esech19/tvc-and-test-rig/README.md

# tvc-and-testing
tvc rocket project and test setup
