esech19/tvc-and-test-rig/Misc/Final Project Timeline.docx

Plan for Final TVC Rocket

Tuesday 4/18

- Discuss testing and make a plan/schedule to work around capstone

Wednesday 4/19

- Could meet with mark at 1pm?
- Work on code - Ian and Jah
  - Either AM or PM, we might be more awake in PM

Thursday 4/20

- Elijah to get transfer functions output from testing after time align
- Ian to get parachute code done and functional by Mark meeting
- Mark meeting @3 PM
- Generate PID values from transfer functions from real dynamics and upload PID values to rocket

Friday 4/21

- Elijah leaves AM

Saturday 4/22

- Elijah gone
- Ian could test the rocket?

Sunday 4/23

- Elijah back PM

Monday 4/24

- New sweep test day, any additional data necessary

Tuesday 4/25

- Get rocket ready for launch
  - Launch lugs
  - Shock cord
  - Deploy final TVC code

Wednesday 4/26

- TVC Test Day 1

Thursday 4/27

- Mark meeting @3 PM

Friday 4/28

Saturday 4/29

- TVC Test Day 2
- Ian needs to work on HRI project some

Sunday 4/30

- Generate any graphs/tables/pictures/videos
- Ian needs to work on HRI project some

Monday 3/1

- Finish poster day

Tuesday 3/2

- Poster complete by noon

Wednesday 3/3

- Poster presentation day
