esech19/tvc-and-test-rig/Misc/Component Weights.xlsx

Rocket | Part | Weight (g) | Total v1 (g) | Total v2
v1 | cardboard | 206 | 738 | 257
v1 | nosecone 3D print | 86
v1 | electrinics bay w/ electronics | 248
v1 | gimbal | 110
v1 | e 12-4 engine | 61
v1 | parachute | 27
v2 | parachute launcher | 257
