esech19/tvc-and-test-rig/Misc/Parts List_.xlsx

Sheet: Testing Rig Parts
Name | Type | Part No. | Price | Quantity | Total | Link | Note
Load Cell - 50kg, Disc (TAS606) | Load cell | SEN-13331 ROHS | 64.5 | 3 | 193.5 | https://www.sparkfun.com/products/13331 | Not sure how to mount this one
Load Sensor - 50kg (Generic) | Load cell | SEN-10245 | 4.50 | 3 | 13.5 | https://www.sparkfun.com/products/10245
Load Cell - 200kg, S-Type (TAS501) | Load cell | SEN-14282 ROHS | 64.5 | 3 | 193.5 | https://www.sparkfun.com/products/14282
NP32HS Series | Encoder | NP32HS R5K L2% (243121) | 15 | 2 | 30
AMT102-0512-I5000-S | Encoder | 490-AMT1020512I5000S | 22.95 | 2 | 45.9 | https://p3america.com/np32hs-series/ | https://www.mouser.com/c/sensors/encoders/?resolution=2048%20PPR&technology=Rotary
Alloy Steel Shoulder Screw,1/4" Shoulder Diameter, 3" Shoulder Length, 10-24 Thread | Shaft | 91259A106 | 2.72 | 4 | 10.88 | https://www.mcmaster.com/91259A106/
Fire Retardant Spray | Fireproofing | B07JBLHGQ8 | 34.95 | 1 | 34.95 | https://www.amazon.com/Retardant-Curtains-Eco-Safe-DRI-ONE-Institute/dp/B07JBLHGQ8
 |  |  | 37.4 | 2 | 74.8 | https://www.digikey.com/en/products/detail/cui-devices/AMT112Q-V-4096/5034549
13 x 46 Feet Anti Bird Netting, Green Garden Netting Protect Fruit and Vegetables from Birds and Animals, Bonus 20 PCS Cable Ties - 0.56 in Mesh | netting for test rig | B08PDGWNPN | 8.99 | 1 | 8.99 | https://www.amazon.com/Netting-Garden-Protect-Vegetables-Animals/dp/B08PDGWNPN
TRUE | SparkFun Load Sensor Combinator | Spark Fun | Combinator board | BOB-13878 ROHS (https://www.sparkfun.com/static/rohs/) | 2.1 | 1 | 2.1 | https://www.sparkfun.com/products/13878
 |  |  |  |  | 0
 |  |  |  |  | 0
 |  |  |  |  | 0
 |  |  |  |  | 0

Sheet: Testing Rig Parts Final
Purchased? | Name | Manufacturer | Type | Part No. | Price | Quantity | Total | Link | Note
TRUE | Load Cell - 200kg, S-Type (TAS501) | Spark Fun | Load cell | SEN-14282 ROHS | 64.5 | 2 | 129 | https://www.sparkfun.com/products/14282 | Not sure how to mount this one
TRUE | SparkFun Load Cell Amplifier - HX711 | Spark Fun | Amplifier Board for Load cells | SEN-13879 ROHS (https://www.sparkfun.com/static/rohs/) | 10.95 | 2 | 21.9 | https://www.sparkfun.com/products/13879
FALSE | AMT112Q-V-4096-ND | Digi Key | Encoder | AMT112Q-V-4096 | 37.4 | 2 | 74.8 | https://www.digikey.com/en/products/detail/cui-devices/AMT112Q-V-4096/5034549
TRUE | AMT103-2048-N4000-S | Digi Key | Encoder | AMT103-2048-N4000-S | 23.18 | 2 | 46.36 | https://www.digikey.com/en/products/detail/cui-devices/AMT103-2048-N4000-S/10468125
TRUE | CUI-435-1FT | Digi Key | encoder cable | CUI-435-1FT | 6.06 | 2 | 12.12 | https://www.digikey.com/en/products/detail/cui-devices/CUI-435-1FT/968159
FALSE | AMT ENCODER CABLE 17CONDUCTOR | Digi Key | cable | AMT-17C-1-036 | 43.54 | 2 | 87.08 | https://www.digikey.com/en/products/detail/cui-devices/AMT-17C-1-036/4864253
FALSE | sd card shield to save data
FALSE | Arduino microcontroller
 | power supply
FALSE | switch
TRUE | Zinc Alloy Tapping Inserts for Softwood, Flanged, 10-24 Thread Size, 25/64" Installed Length | McMaster Carr | inserts | 92105A006 (https://www.mcmaster.com/92105A006) | 8.08 | 1 | 8.08
TRUE | Worm-Drive Clamps for Firm Hose and Tube, Steel Screw, 9/16" Wide Band, 3-5/8" to 6-1/2" Clamp ID | MacMaster Carr | Hose clamp | 5415K87 (https://www.mcmaster.com/5415K87) | 14.6 | 1 | 14.6
TRUE | Alloy Steel Shoulder Screw, 1/4" Shoulder Diameter, 2-1/4" Shoulder Length, 10-24 Thread | McMaster Carr | Shoulder bolt | 91259A104 (https://www.mcmaster.com/91259A104) | 2.52 | 2 | 5.04 | https://www.mcmaster.com/catalog-128%2f3394/
TRUE | Alloy Steel Shoulder Screw 1/4" Shoulder Diameter, 1-3/8" Shoulder Length, 10-24 Thread | McMaster Carr | Shoulder bolt | 91259A471 (https://www.mcmaster.com/91259A471/) | 4.76 | 1 | 4.76
TRUE | 1/4" Shoulder Diameter, 1.75" Shoulder Length, 10-24 Thread | McMaster Carr | Shoulder bolt | 91259A102 (https://www.mcmaster.com/91259A102/) | 2.18 | 1 | 2.18
TRUE | Alloy Steel Socket Head Screw Black-Oxide, M12 x 1.75 mm Thread, 95 mm Long | McMaster Carr | Load cell bolt | 91290A367 (https://www.mcmaster.com/91290A367/) | 14.41 | 1 | 14.41 | https://www.mcmaster.com/91290A367/
TRUE | Aluminum Unthreaded Inserts for Plastic for 1/4" Screw Size, 1/4" Long | McMaster Carr | Gimbal hardware | 93729A108 (https://www.mcmaster.com/93729A108/) | 9.34 | 2 | 18.68
TRUE | Lubricant-Filled Nylon Plastic Washer for Number 12 Screw Size, 0.25" ID, 0.562" OD | McMaster Carr | Gimbal hardware | 91545A330 (https://www.mcmaster.com/91545A330/) | 4.14 | 2 | 8.28
FALSE | Fire Retardant Spray | amazon | Fireproofing | B07JBLHGQ8 | 34.95 | 1 | 34.95 | https://www.amazon.com/Retardant-Curtains-Eco-Safe-DRI-ONE-Institute/dp/B07JBLHGQ8 | https://www.mouser.com/c/sensors/encoders/?resolution=2048%20PPR&technology=Rotary
FALSE | Amazon Basics ABS 3D Printer Filament, 1.75mm, Red, 1 kg Spool |  | 3d Printing Spool |  | 20 | 5 | 100 | https://www.amazon.com/HATCHBOX-3D-Filament-Dimensional-Accuracy/dp/B00J0H8EWA?s=industrial |  | amazon
FALSE | 2x4 |  | Wood | N/A | 5 | 10 | 50 | none
FALSE | Zinc-Plated Steel Corner Bracket, 3" x 3" x 3/4" |  | angle brackets | 1556A36 (https://www.mcmaster.com/1556A36) | 1.43 | 4 | 5.72 | https://www.mcmaster.com/1556a35-zinc-plated-steel-corner-brackets/finish~zinc-plated/corner-brackets-5/
FALSE
FALSE
FALSE
FALSE
FALSE
FALSE
FALSE
FALSE
FALSE
FALSE
FALSE
FALSE
FALSE
FALSE
FALSE
FALSE
FALSE
FALSE
FALSE
FALSE
FALSE
FALSE
FALSE
FALSE
FALSE
FALSE
FALSE
FALSE
FALSE
FALSE
FALSE
FALSE
FALSE
FALSE
FALSE
FALSE
FALSE
FALSE
FALSE
FALSE
FALSE
FALSE
FALSE
FALSE
FALSE
FALSE
FALSE
FALSE
FALSE
FALSE
FALSE
FALSE
FALSE
FALSE
FALSE
FALSE
FALSE
FALSE
FALSE
FALSE
FALSE
FALSE
FALSE
FALSE
FALSE
FALSE
FALSE
FALSE
FALSE
FALSE
FALSE
FALSE
FALSE
FALSE
FALSE
FALSE
FALSE
FALSE
FALSE
FALSE
FALSE
FALSE
FALSE
FALSE
FALSE
FALSE
FALSE
FALSE
FALSE
FALSE
FALSE
FALSE
FALSE
FALSE
FALSE
FALSE
FALSE
FALSE
FALSE
FALSE
FALSE
FALSE
FALSE
FALSE
FALSE
FALSE
FALSE
FALSE
FALSE
FALSE
FALSE
FALSE
FALSE
FALSE
FALSE
FALSE
FALSE
FALSE
FALSE
FALSE
FALSE
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
FALSE
FALSE
FALSE
FALSE
FALSE
FALSE
FALSE
FALSE
FALSE
FALSE
FALSE
FALSE
FALSE
FALSE
FALSE
FALSE
FALSE
FALSE
FALSE
FALSE
FALSE
FALSE
FALSE
FALSE
FALSE
FALSE
FALSE
FALSE
FALSE
FALSE
FALSE
FALSE
FALSE
FALSE
FALSE
FALSE
FALSE
FALSE
FALSE
FALSE
FALSE
FALSE
FALSE
FALSE
FALSE
FALSE
FALSE
FALSE
FALSE
FALSE
FALSE
FALSE
FALSE
FALSE
FALSE
FALSE
FALSE
FALSE
FALSE
FALSE
FALSE
FALSE
FALSE
FALSE
FALSE
FALSE
FALSE
FALSE
FALSE
FALSE
FALSE
FALSE
FALSE
FALSE
FALSE
FALSE
FALSE
FALSE
FALSE
FALSE
FALSE
FALSE
FALSE
FALSE
FALSE
FALSE
FALSE
FALSE
FALSE
FALSE
FALSE
FALSE
FALSE
FALSE
FALSE
FALSE
FALSE
FALSE
FALSE
FALSE
FALSE
FALSE
FALSE
FALSE
FALSE
FALSE
FALSE
FALSE
FALSE
FALSE
FALSE
FALSE
FALSE
FALSE
FALSE
FALSE
FALSE
FALSE
FALSE
FALSE
FALSE
FALSE
FALSE
FALSE
FALSE
FALSE
FALSE
FALSE
FALSE
FALSE
FALSE
FALSE
FALSE
FALSE
FALSE
FALSE
FALSE
FALSE
FALSE
FALSE
FALSE
FALSE
FALSE
FALSE
FALSE
FALSE
FALSE
FALSE
FALSE
FALSE
FALSE
FALSE
FALSE
FALSE
FALSE
FALSE
FALSE
FALSE
FALSE
FALSE
FALSE

Sheet: Electronics
Name | Part No. | Price | Quantity | Total | Link | Note
Arduino Nano 33 BLE with headers | ABX00034 | 29.3 | 1 | 29.3 | https://store-usa.arduino.cc/collections/boards/products/arduino-nano-33-ble-with-headers
 |  |  |  | 0
 |  |  |  | 0
 |  |  |  | 0
 |  |  |  | 0
 |  |  |  | 0
 |  |  |  | 0
 |  |  |  | 0
 |  |  |  | 0
 |  |  |  | 0
 |  |  |  | 0
 |  |  |  | 0
 |  |  |  | 0
 |  |  |  | 0

Sheet: SURG Parts
 |  |  |  |  |  | 1005.75
Name | Vendor | Type | Part No. | Price | Quantity | Total | Link | Note
Load Cell - 50kg, Disc (TAS606) | Sparkfun | Load cell | SEN-13331 ROHS | 64.5 | 2 | 129 | here (https://www.sparkfun.com/products/13331)
Alloy Steel Shoulder Screw,1/4" Shoulder Diameter, 3" Shoulder Length, 10-24 Thread | Mcmaster Carr | Shaft | 91259A106 | 2.72 | 4 | 10.88 | here (https://www.mcmaster.com/91259A106/) | mcmaster carr
Fire Retardant Spray | Amazon | Fireproofing | B07JBLHGQ8 | 34.95 | 1 | 34.95 | here (https://www.amazon.com/Retardant-Curtains-Eco-Safe-DRI-ONE-Institute/dp/B07JBLHGQ8)
AMT112Q-V-4096 | Digi Key | Encoder | AMT112Q-V-4096 | 37.4 | 2 | 74.8 | here (https://www.digikey.com/en/products/detail/cui-devices/AMT112Q-V-4096/5034549)
2x4 | Home Depot | lumber |  | 5 | 10 | 50
Amazon Basics ABS 3D Printer Filament, 1.75mm, Red, 1 kg Spool | Amazon | 3d printing material |  | 20 | 5 | 100 | here (https://www.amazon.com/AmazonBasics-Printer-Filament-1-75mm-Spool/dp/B07Y3PHD2C) | amazon
AEROTECH 29MM HP SU DMS MOTOR - G12ST-P | Apogee Rockets | Rocket Motor | 81275 | 41.72 | 14 | 584.08 | here (https://www.apogeerockets.com/Rocket-Motors/AeroTech-Motors/29mm-Motors-Single-Use/Aerotech-29mm-HP-SU-DMS-Motor-G12ST-P)
13 x 46 Feet Anti Bird Netting, Green Garden Netting Protect Fruit and Vegetables from Birds and Animals, Bonus 20 PCS Cable Ties - 0.56 in Mesh | netting for test rig | B08PDGWNPN | 8.99 | 8.99 | 1 | 8.99 | here (https://www.amazon.com/Netting-Garden-Protect-Vegetables-Animals/dp/B08PDGWNPN)
SparkFun Load Cell Amplifier - HX711 | Amplifier Board for Load cells | SEN-13879 ROHS | 10.95 | 10.95 | 1 | 10.95 | here (https://www.sparkfun.com/products/13879)
SparkFun Load Sensor Combinator | Combinator board | BOB-13878 ROHS | 2.1 | 2.1 | 1 | 2.1 | here (https://www.sparkfun.com/products/13878)
 |  |  |  |  |  | 0

Sheet: Rocket 1 parts
Purchased? | Name | Manufacturer | Type | Part No. | Price | Quantity | Total | Link
FALSE | KST X06 Micro Digital Metal Gear Thin Servo |  | servo |  |  |  | 0 | https://www.amainhobbies.com/kst-x06-micro-digital-metal-gear-thin-servo-kst-x06/p1310013
FALSE | theta servo brushless |  |  |  |  |  | 0 | https://www.amainhobbies.com/theta-servos-thm988-brushless-mini-high-voltage-servo-ts-thm988/p1414874
TRUE | Arduino Nano 33 BLE [ABX00030] - | Arduino |  | B07WV59YTZ | 25 | 1 | 25 | https://www.amazon.com/Arduino-Nano-33-BLE/dp/B07WV59YTZ
TRUE | BMP390 Precision Barometric Pressure and Altimeter Sensor for Arduino | Adafruit | sensor | 4816 | 21 | 1 | 21 | https://www.adafruit.com/product/4816
TRUE | MG90S 9g Servo Motor Micro Metal Gear for Robot Car Plane RC Helicopter Arduino | ? |  | B07L6FZVT1 |  |  | 0 | https://www.amazon.com/MG90S-Servo-Motor-Helicopter-Arduino/dp/B07L6FZVT1/ref=sr_1_
TRUE | RC Plane battery 7.4V | Bloomisky |  | 0936T9B22 |  |  | 0 | https://www.amazon.com/Blomiky-500mAh-Rechargeable-Battery-Blaster/dp/B0936T9B22 7.4V 500mAh Li-ion Rechargeable Battery fit for WPL D12 RC Truck Anstoy 1085 1086 Gel Ball Blaster D12 Battery 2 -
TRUE | LM1085IT-5.0/NOPB | texas instruments | power converter | LM1085IT-5.0/NOPB-ND | 2.46 | 1 | 2.46 | https://www.digikey.com/en/products/detail/texas-instruments/LM1085IT-5-0-NOPB/363564
TRUE | TAP106K020SRW |  | capacitor | 478-8956-1-ND - Cut Tape (CT) | 0.25728 | 2 | 0.51456 | https://www.digikey.com/en/products/detail/kyocera-avx/TAP106K020SRW/1471143
TRUE | CAB-14574 | sparkfun, from digikey | battery connector |  | 1.06 | 1 | 1.06 | https://www.digikey.com/en/products/detail/sparkfun-electronics/CAB-14574/8543394
TRUE | PPTC151LFBN-RC |  |  | S7013-ND | 0.98 | 2 | 1.96 | https://www.digikey.com/en/products/detail/sullins-connector-solutions/PPTC151LFBN-RC/810153
TRUE | PPTC081LFBN-RC |  |  | S7006-ND | 0.65 | 1 | 0.65 | https://www.digikey.com/en/products/detail/sullins-connector-solutions/PPTC081LFBN-RC/810147
TRUE | PPTC061LFBN-RC |  |  | S7004-ND | 0.52 | 1 | 0.52 | https://www.digikey.com/en/products/detail/sullins-connector-solutions/PPTC061LFBN-RC/810145
TRUE | 10129378-936003BLF |  |  | 10129378-936003BLF-ND | 0.58 | 10 | 5.8 | https://www.digikey.com/en/products/detail/amphenol-cs-fci/10129378-936003BLF/7915975
FALSE |  |  |  |  |  |  | 0
FALSE |  |  |  |  |  |  | 0
FALSE |  |  |  |  |  |  | 0
FALSE |  |  |  |  |  |  | 0
FALSE |  |  |  |  |  |  | 0
FALSE |  |  |  |  |  |  | 0
FALSE |  |  |  |  |  |  | 0
FALSE |  |  |  |  |  |  | 0
FALSE |  |  |  |  |  |  | 0
FALSE |  |  |  |  |  |  | 0
FALSE |  |  |  |  |  |  | 0
FALSE |  |  |  |  |  |  | 0
FALSE |  |  |  |  |  |  | 0
FALSE |  |  |  |  |  |  | 0
FALSE |  |  |  |  |  |  | 0
FALSE |  |  |  |  |  |  | 0
FALSE |  |  |  |  |  |  | 0
FALSE |  |  |  |  |  |  | 0
FALSE |  |  |  |  |  |  | 0
FALSE |  |  |  |  |  |  | 0
FALSE |  |  |  |  |  |  | 0
FALSE |  |  |  |  |  |  | 0
FALSE |  |  |  |  |  |  | 0
FALSE |  |  |  |  |  |  | 0
FALSE |  |  |  |  |  |  | 0
FALSE |  |  |  |  |  |  | 0
FALSE |  |  |  |  |  |  | 0
FALSE |  |  |  |  |  |  | 0
FALSE |  |  |  |  |  |  | 0
FALSE |  |  |  |  |  |  | 0
FALSE |  |  |  |  |  |  | 0
FALSE |  |  |  |  |  |  | 0
FALSE |  |  |  |  |  |  | 0
FALSE |  |  |  |  |  |  | 0
FALSE |  |  |  |  |  |  | 0
FALSE |  |  |  |  |  |  | 0
FALSE |  |  |  |  |  |  | 0
FALSE |  |  |  |  |  |  | 0
FALSE |  |  |  |  |  |  | 0
FALSE |  |  |  |  |  |  | 0
FALSE |  |  |  |  |  |  | 0
FALSE |  |  |  |  |  |  | 0
FALSE |  |  |  |  |  |  | 0
FALSE |  |  |  |  |  |  | 0
FALSE
FALSE
FALSE
FALSE
FALSE
FALSE
FALSE
FALSE
FALSE
FALSE
FALSE
FALSE
FALSE
FALSE
FALSE
FALSE
FALSE
FALSE
FALSE
FALSE
FALSE
FALSE
FALSE
FALSE
FALSE
FALSE
FALSE
FALSE
FALSE
FALSE
FALSE
FALSE
FALSE
FALSE
FALSE
FALSE
FALSE
FALSE
FALSE
FALSE
FALSE
FALSE
FALSE
FALSE
FALSE
FALSE
FALSE
FALSE
FALSE
FALSE
FALSE
FALSE
FALSE
FALSE
FALSE
FALSE
FALSE
FALSE
FALSE
FALSE
FALSE
FALSE
FALSE
FALSE
FALSE
FALSE
FALSE
FALSE
FALSE
FALSE
FALSE
FALSE
FALSE
FALSE
FALSE
FALSE
FALSE
FALSE
FALSE
FALSE
FALSE
FALSE
FALSE
FALSE
FALSE
FALSE
FALSE
FALSE
FALSE
FALSE
FALSE
FALSE
FALSE
FALSE
FALSE
FALSE
FALSE
FALSE
FALSE
FALSE
FALSE
FALSE
FALSE
FALSE
FALSE
FALSE
FALSE
FALSE
FALSE
FALSE
FALSE
FALSE
FALSE
FALSE
FALSE
FALSE
FALSE
FALSE
FALSE
FALSE
FALSE
FALSE
FALSE
FALSE
FALSE
FALSE
FALSE
FALSE
FALSE
FALSE
FALSE
FALSE
FALSE
FALSE
FALSE
FALSE
FALSE
FALSE
FALSE
FALSE
FALSE
FALSE
FALSE
FALSE
FALSE
FALSE
FALSE
FALSE
FALSE
FALSE
FALSE
FALSE
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
FALSE
FALSE
FALSE
FALSE
FALSE
FALSE
FALSE
FALSE
FALSE
FALSE
FALSE
FALSE
FALSE
FALSE
FALSE
FALSE
FALSE
FALSE
FALSE
FALSE
FALSE
FALSE
FALSE
FALSE
FALSE
FALSE
FALSE
FALSE
FALSE
FALSE
FALSE
FALSE
FALSE
FALSE
FALSE
FALSE
FALSE
FALSE
FALSE
FALSE
FALSE
FALSE
FALSE
FALSE
FALSE
FALSE
FALSE
FALSE
FALSE
FALSE
FALSE
FALSE
FALSE
FALSE
FALSE
FALSE
FALSE
FALSE
FALSE
FALSE
FALSE
FALSE
FALSE
FALSE
FALSE
FALSE
FALSE
FALSE
FALSE
FALSE
FALSE
FALSE
FALSE
FALSE
FALSE
FALSE
FALSE
FALSE
FALSE
FALSE
FALSE
FALSE
FALSE
FALSE
FALSE
FALSE
FALSE
FALSE
FALSE

Sheet: Funding
Grant | Value | Total Grant $ | 500 | Purchase | Date | Value | Total
Holleran Feedback | 500 | Remaining $ | 206.3 | Rig Parts - McMaster Carr, Digi Key, Spark Fun | 2002-10-27 | 293.7 | 293.7

Sheet: Rocket 2 (rebuild)
Purchased? | Name | Manufacturer | Type | Part No. | Price | Quantity | Total | Link
FALSE | 36" PRINTED NYLON PARACHUTE | Apogee Compenents | Parachute | 29095 | 18.69 | 1 | 18.69 | https://www.apogeerockets.com/Building-Supplies/Parachutes/Larger-than-24in/36in-Printed-Nylon-Parachute
FALSE | Estes Motors - F15-8 | Apogee Compenents | Rocket Engines | 5797 | 33.69 | 2 | 67.38 | https://www.apogeerockets.com/Rocket_Motors/Estes_Motors/29mm_Motors/Estes_Motors_F15-8
