esech19/tvc-and-test-rig/Misc/SURG.xlsx

Item | Cost
36" PRINTED NYLON PARACHUTE | 18.69
1/8" DIAMETER HEAVY-DUTY ELASTIC SHOCK CORD | 5.3
APOGEE 12IN PARACHUTE PROTECTOR | 9.66
560PCS Heat Shrink Tubing 2:1,Electrical Wire Cable Wrap Assortment Electric Insulation Heat Shrink Tube Kit with Box | 6.59
MAIYUM 63-37 Tin Lead Rosin Core Solder Wire for Electrical Soldering (0.6mm 50g) | 8.99
YIHUA 926 III 60W Digital Display Soldering Iron Station Kit w 2 Helping Hands, 6 Extra Iron Tips, Lead-Free Solder, Solder Sucker, S/S Tweezers, °C/ºF Conversion, Auto Sleep & Calibration Support | 42.99
ESTES MOTORS - E12-0 | 89.23
ESTES MOTORS - F15-0 | 67.38
POGEE MEDALIST MOTOR - F10-4 (1PK) | 69.2
GoPro HERO10 Black Bundle: Dual Charger, Extra Battery, 64GB SD Card | 559.98
Stratasys | 175.29
 |  | 1053.3
