esech19/tvc-and-test-rig/CAD/files/Testing Rig/9-22-2022/TVC ROCKET TEST RIG_9_22_2022.SLDASM

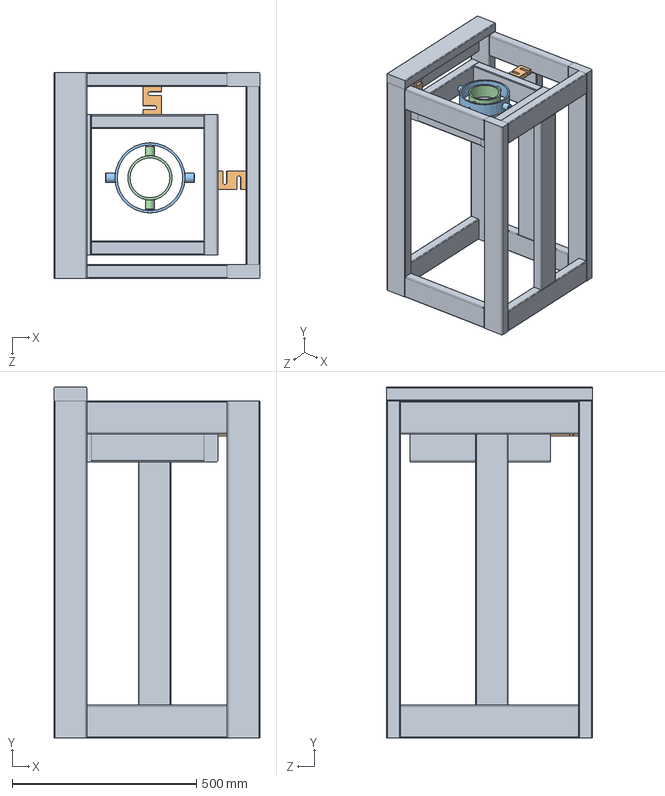
[picture p2: CAD file, 2023-10-02]
CAD/files/Testing Rig/9-22-2022/TVC ROCKET TEST RIG_9_22_2022.SLDASM
558.8 x 952.5 x 558.8 mm
2x4 x 19
S Tyep Load Cell TAS501 x 3
Outer Gimbal Ring
Inner Gimbal Ring
