esech19/tvc-and-test-rig/CAD/files/Testing Rig/10-5-2022/CAD/Test Rig Gimbal.SLDASM

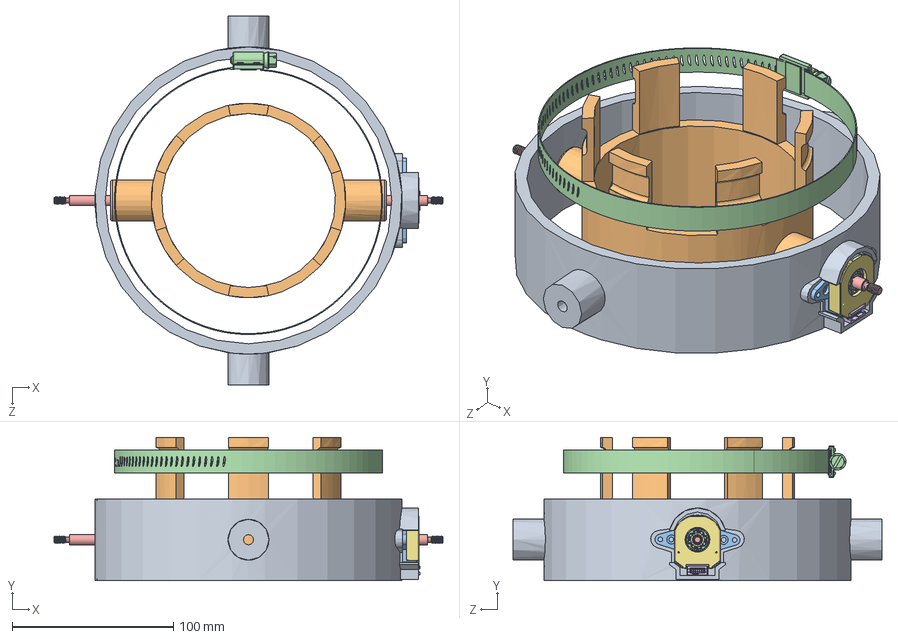
[picture p3: CAD file, 2023-10-02]
CAD/files/Testing Rig/10-5-2022/CAD/Test Rig Gimbal.SLDASM
241.3 x 88.9 x 228.6 mm
Outer Gimbal Ring
Inner Gimbal Ring
CUI_DEVICES_Rotor_16f_5c_Rev_D
CUI_DEVICES_AMT-Overmold_Hub-REV_A
CUI_DEVICES_Transmitter-board(AMT203-303)
CUI_DEVICES_TFML-107-01-X-D-BASIC
CUI_DEVICES_AMT-203_303-Top-Cover_Rev_H
CUI_DEVICES_AMT-Shaft-Adaptor-REVD_Fixed
CUI_DEVICES_Receiver-board
CUI_DEVICES_AMT-Sleeve-REV-D( 2 mm)
CUI_DEVICES_amt-x03-wide-base rev b(default)
5415K87_Worm-Drive Clamps for Firm Hose and Tube
91259A103_Alloy Steel Shoulder Screw x 2
