esech19/tvc-and-test-rig/CAD/files/Testing Rig/9-22-2022/Gimbal Attachment Frame_9_22_2022.SLDASM

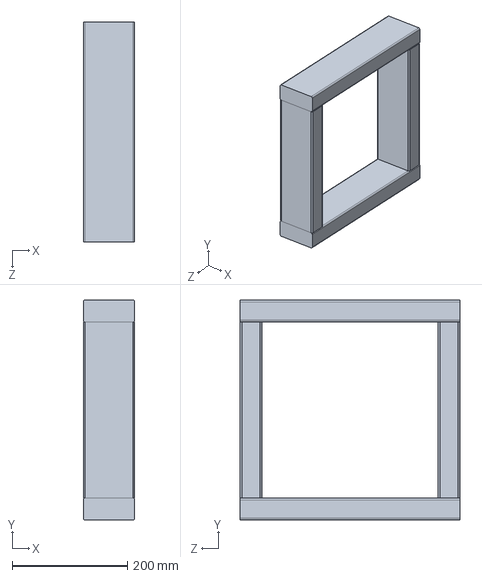
[picture p4: CAD file, 2023-10-02]
CAD/files/Testing Rig/9-22-2022/Gimbal Attachment Frame_9_22_2022.SLDASM
88.9 x 381.0 x 381.0 mm
2x4 x 4
