esech19/tvc-and-test-rig/CAD/files/Testing Rig/9-22-2022/Wooden Structure_9_22_2022.SLDASM

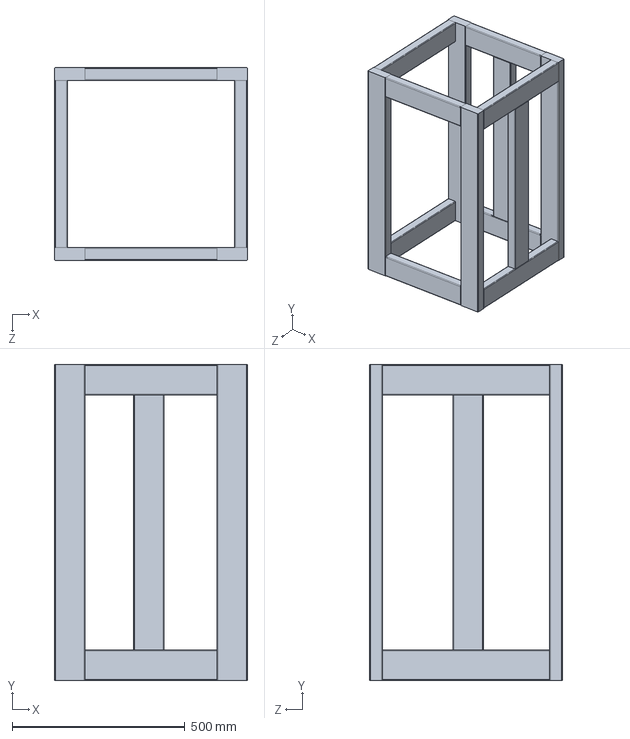
[picture p5: CAD file, 2023-10-02]
CAD/files/Testing Rig/9-22-2022/Wooden Structure_9_22_2022.SLDASM
558.8 x 914.4 x 558.8 mm
2x4 x 14
