esech19/tvc-and-test-rig/CAD/files/Testing Rig/V3/TVC ROCKET TEST RIG.SLDASM

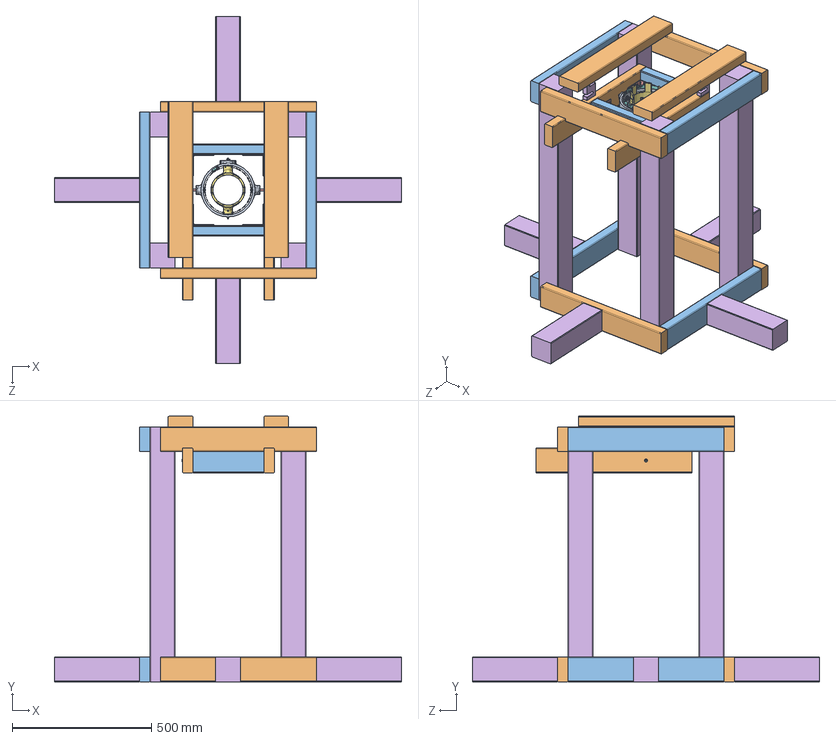
[picture p6: CAD file, 2023-10-02]
CAD/files/Testing Rig/V3/TVC ROCKET TEST RIG.SLDASM
1244.6 x 952.5 x 1244.6 mm
2x4 x 14
92105A006_Zinc Alloy Tapping Inserts for Softwood x 2
1556A36_Zinc-Plated Steel Corner Bracket x 4
S Tyep Load Cell TAS501 x 2
Outer Gimbal Ring
Inner Gimbal Ring
91259A103_Alloy Steel Shoulder Screw
91259A471_Alloy Steel Shoulder Screw
91545A330_Lubricant-Filled Nylon Plastic Washer x 2
CUI_DEVICES_amt-sleeve-rev-d(4mm)
CUI_DEVICES_amt-hub-top-rev-d1
CUI_DEVICES_amt-hub-bottom-rev-b
CUI_DEVICES_amt10x-shaft-adaptor-rev-e
CUI_DEVICES_receiver-board
CUI_DEVICES_rotor-board-rev f
CUI_DEVICES_transmitter-board amt10(amt-103)
CUI_DEVICES_amt-103-base-rev-k(default)
CUI_DEVICES_amt-103-top-cover-rev-i
91259A104_Alloy Steel Shoulder Screw x 2
4x4 x 8
