esech19/tvc-and-test-rig/CAD/files/Testing Rig/10-3-22/CUI_DEVICES_CUI_DEVICES_AMT113S-0048-2000-S.SLDASM

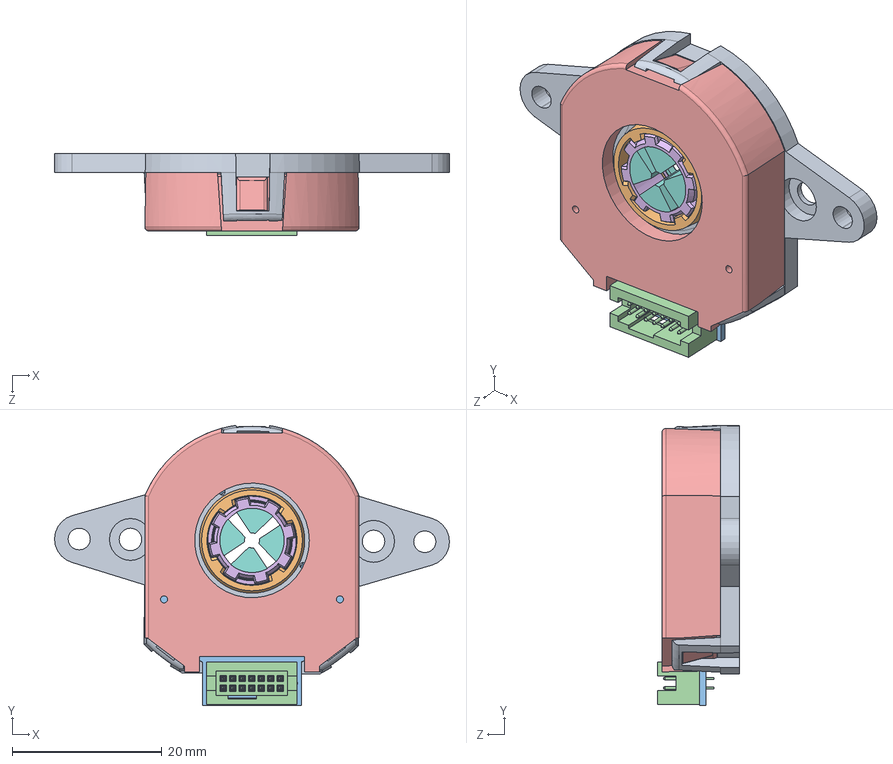
[picture p7: CAD file, 2023-10-02]
CAD/files/Testing Rig/10-3-22/CUI_DEVICES_CUI_DEVICES_AMT113S-0048-2000-S.SLDASM
52.7 x 37.4 x 10.9 mm
CUI_DEVICES_Rotor_16f_5c_Rev_D
CUI_DEVICES_AMT-Overmold_Hub-REV_A
CUI_DEVICES_Transmitter-board(AMT203-303)
CUI_DEVICES_TFML-107-01-X-D-BASIC
CUI_DEVICES_AMT-203_303-Top-Cover_Rev_H
CUI_DEVICES_AMT-Shaft-Adaptor-REVD_Fixed
CUI_DEVICES_Receiver-board
CUI_DEVICES_AMT-Sleeve-REV-D( 2 mm)
CUI_DEVICES_amt-x03-wide-base rev b(default)
