esech19/tvc-and-test-rig/CAD/files/Testing Rig/9-22-2022/Test Rig Gimbal_9_22_2022.SLDASM

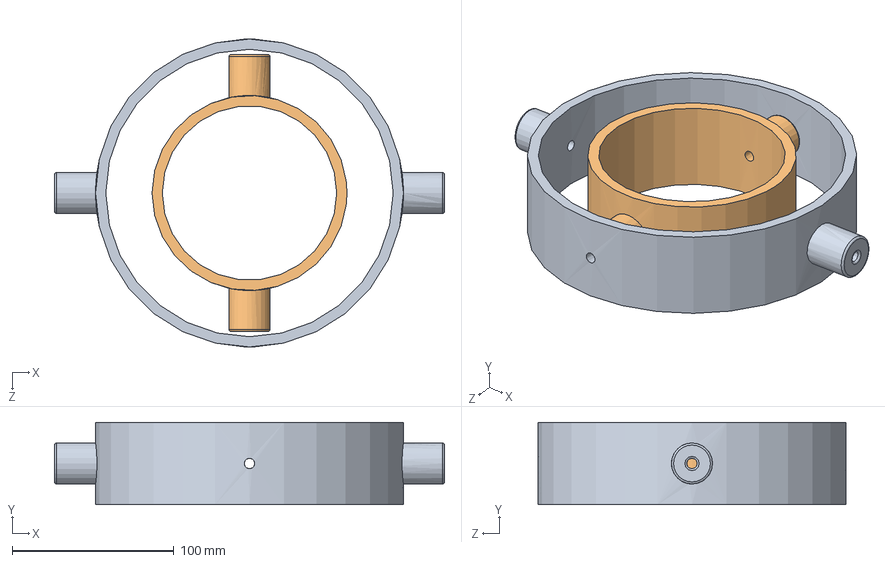
[picture p8: CAD file, 2023-10-02]
CAD/files/Testing Rig/9-22-2022/Test Rig Gimbal_9_22_2022.SLDASM
241.3 x 50.8 x 190.5 mm
Outer Gimbal Ring
Inner Gimbal Ring
