esech19/tvc-and-test-rig/CAD/files/Testing Rig/10-5-2022/CAD/Gimbal Attachment Frame.SLDASM

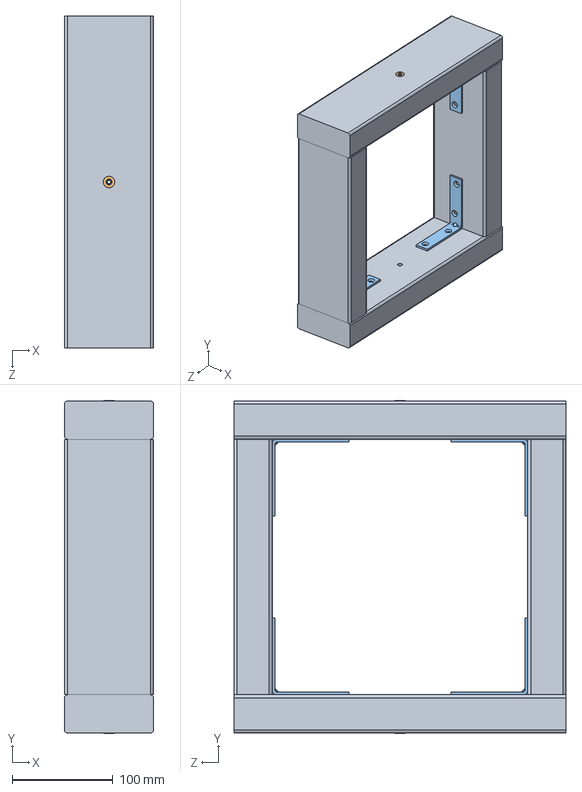
[picture p9: CAD file, 2023-10-02]
CAD/files/Testing Rig/10-5-2022/CAD/Gimbal Attachment Frame.SLDASM
88.9 x 331.3 x 330.2 mm
2x4 x 4
92105A006_Zinc Alloy Tapping Inserts for Softwood x 2
1556A36_Zinc-Plated Steel Corner Bracket x 4
