esech19/tvc-and-test-rig/CAD/files/Testing Rig/V3/Test Rig Gimbal.SLDASM

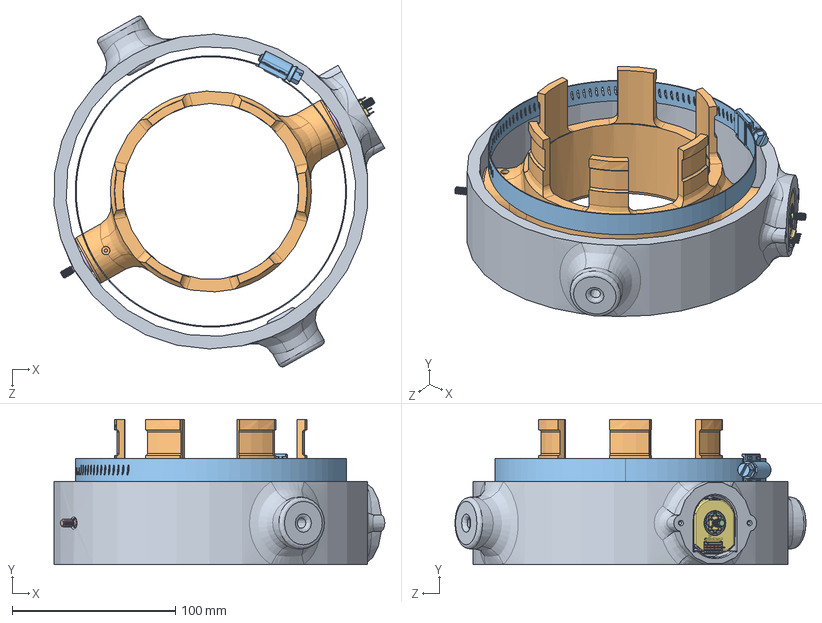
[picture p10: CAD file, 2023-10-02]
CAD/files/Testing Rig/V3/Test Rig Gimbal.SLDASM
202.7 x 88.9 x 215.2 mm
Outer Gimbal Ring
5415K87_Worm-Drive Clamps for Firm Hose and Tube
91545A330_Lubricant-Filled Nylon Plastic Washer
CUI_DEVICES_amt-sleeve-rev-d(4mm)
CUI_DEVICES_amt-hub-top-rev-d1
CUI_DEVICES_amt-hub-bottom-rev-b
CUI_DEVICES_amt10x-shaft-adaptor-rev-e
CUI_DEVICES_receiver-board
CUI_DEVICES_rotor-board-rev f
CUI_DEVICES_transmitter-board amt10(amt-103)
CUI_DEVICES_amt-103-base-rev-k(default)
CUI_DEVICES_amt-103-top-cover-rev-i
