esech19/tvc-and-test-rig/CAD/files/Testing Rig/10-3-22/TVC ROCKET TEST RIG.SLDASM

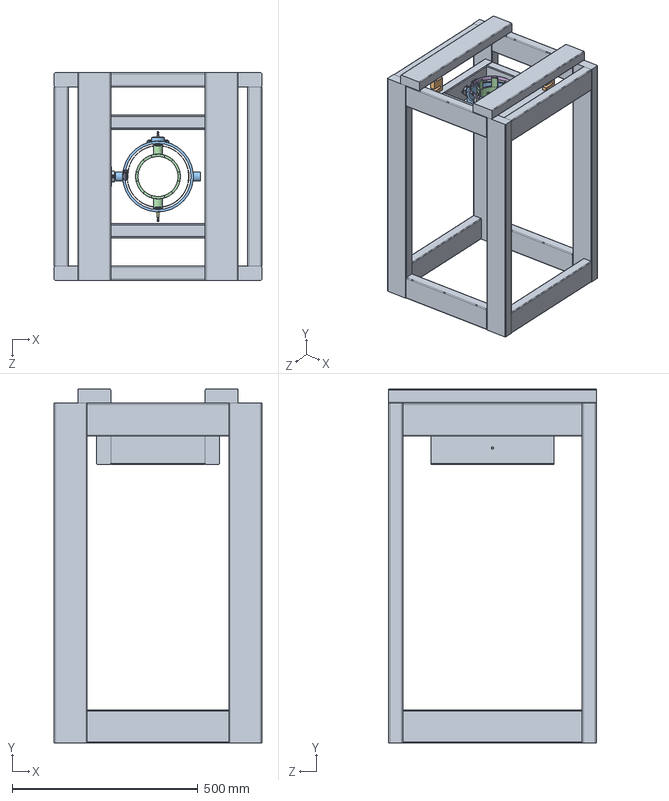
[picture p11: CAD file, 2023-10-02]
CAD/files/Testing Rig/10-3-22/TVC ROCKET TEST RIG.SLDASM
558.8 x 952.5 x 558.8 mm
2x4 x 18
S Tyep Load Cell TAS501 x 2
Outer Gimbal Ring
Inner Gimbal Ring
CUI_DEVICES_Rotor_16f_5c_Rev_D x 2
CUI_DEVICES_AMT-Overmold_Hub-REV_A x 2
CUI_DEVICES_Transmitter-board(AMT203-303) x 2
CUI_DEVICES_TFML-107-01-X-D-BASIC x 2
CUI_DEVICES_AMT-203_303-Top-Cover_Rev_H x 2
CUI_DEVICES_AMT-Shaft-Adaptor-REVD_Fixed x 2
CUI_DEVICES_Receiver-board x 2
CUI_DEVICES_AMT-Sleeve-REV-D( 2 mm) x 2
CUI_DEVICES_amt-x03-wide-base rev b(default) x 2
5415K87_Worm-Drive Clamps for Firm Hose and Tube
91259A103_Alloy Steel Shoulder Screw x 2
