esech19/tvc-and-test-rig/CAD/files/Testing Rig/10-3-22/Wooden Structure.SLDASM

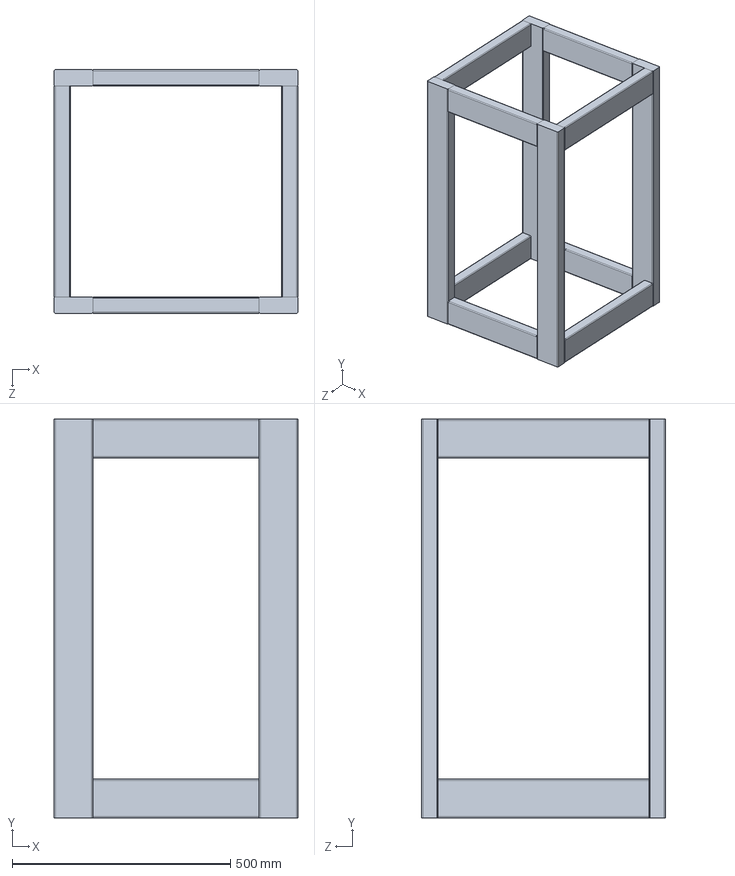
[picture p12: CAD file, 2023-10-02]
CAD/files/Testing Rig/10-3-22/Wooden Structure.SLDASM
558.8 x 914.4 x 558.8 mm
2x4 x 12
