esech19/tvc-and-test-rig/CAD/files/Testing Rig/10-3-22/Gimbal Attachment Frame.SLDASM

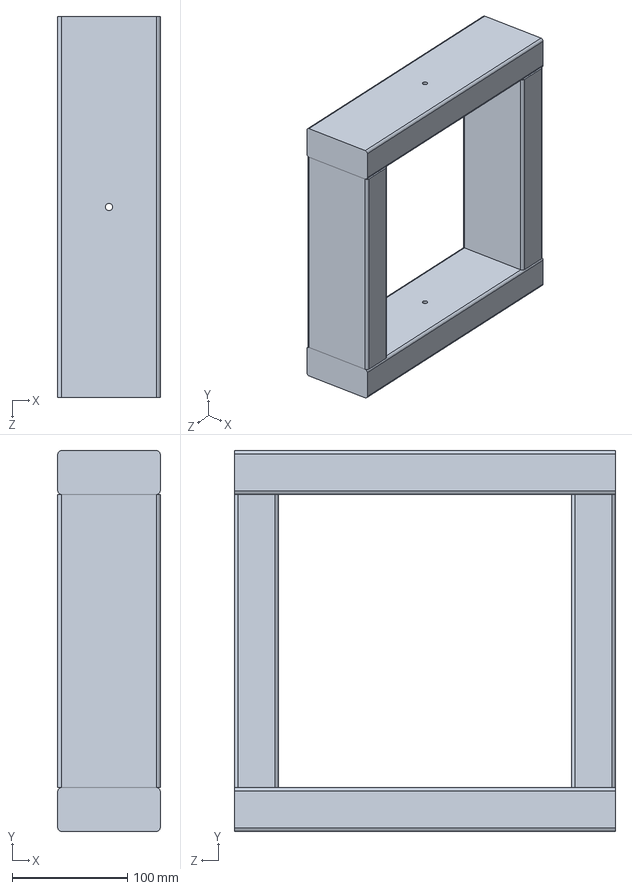
[picture p13: CAD file, 2023-10-02]
CAD/files/Testing Rig/10-3-22/Gimbal Attachment Frame.SLDASM
88.9 x 330.2 x 330.2 mm
2x4 x 4
