esech19/tvc-and-test-rig/CAD/files/Testing Rig/V3/Wooden Structure v2.SLDASM

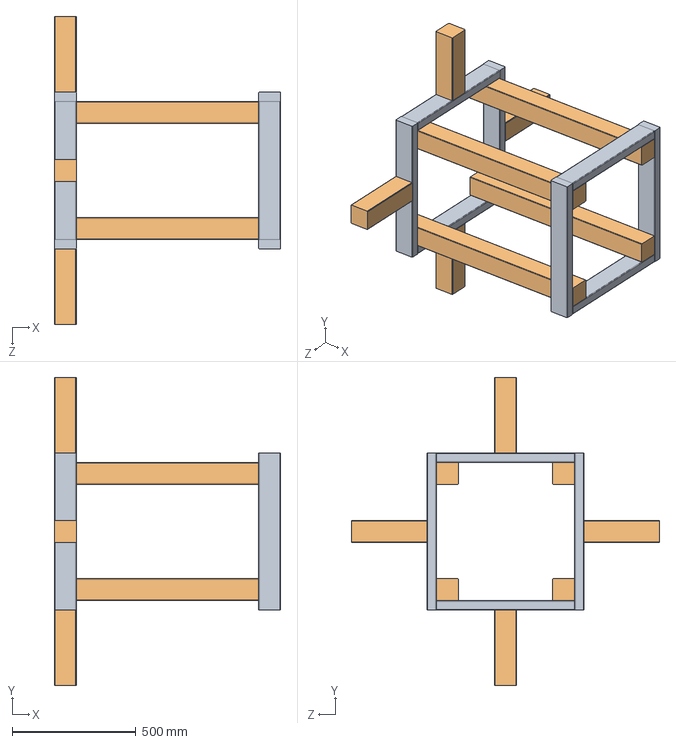
[picture p14: CAD file, 2023-10-02]
CAD/files/Testing Rig/V3/Wooden Structure v2.SLDASM
914.4 x 1244.6 x 1244.6 mm
2x4 x 8
4x4 x 8
