esech19/tvc-and-test-rig/CAD/files/Parachute Mechanism/Concept 1 - Spring Trigger/Lever.SLDPRT

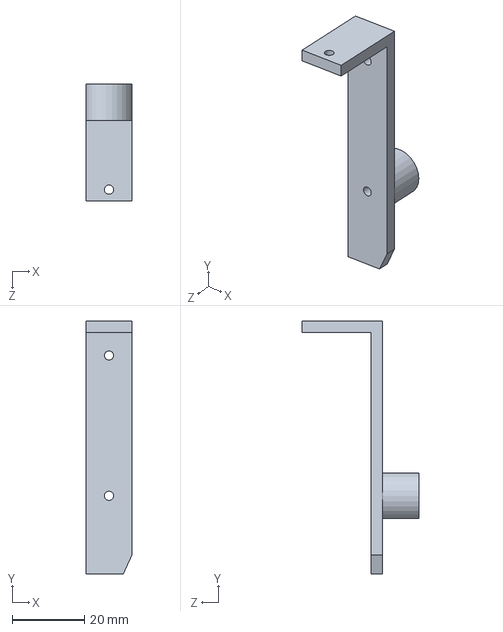
[picture p15: CAD file, 2023-10-02]
CAD/files/Parachute Mechanism/Concept 1 - Spring Trigger/Lever.SLDPRT
12.7 x 69.8 x 32.4 mm
