esech19/tvc-and-test-rig/CAD/files/Parachute Mechanism/Spring Trigger Prototype/Bottom Disc.SLDPRT

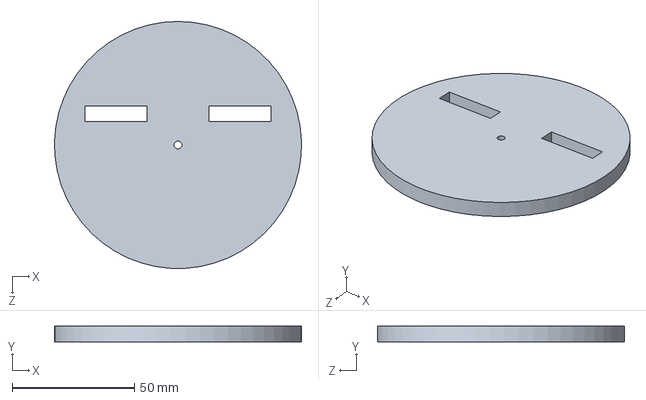
[picture p16: CAD file, 2023-10-02]
CAD/files/Parachute Mechanism/Spring Trigger Prototype/Bottom Disc.SLDPRT
101.0 x 6.35 x 101.1 mm
