esech19/tvc-and-test-rig/CAD/files/Testing Rig/V3/2x4.SLDPRT

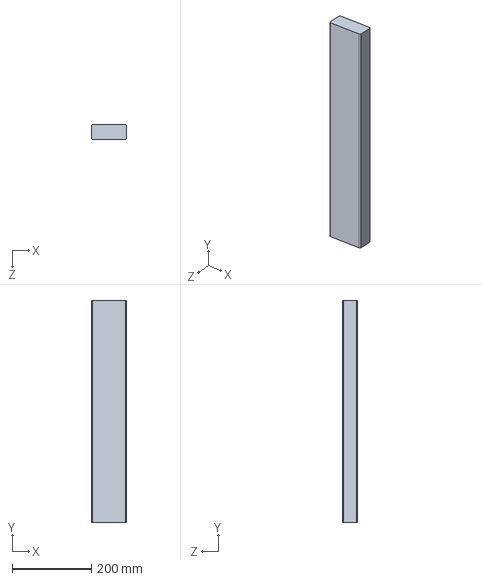
[picture p17: CAD file, 2023-10-02]
CAD/files/Testing Rig/V3/2x4.SLDPRT
88.9 x 558.8 x 38.1 mm
