esech19/tvc-and-test-rig/CAD/files/Parachute Mechanism/Spring Trigger Prototype/Trigger Lever.SLDPRT

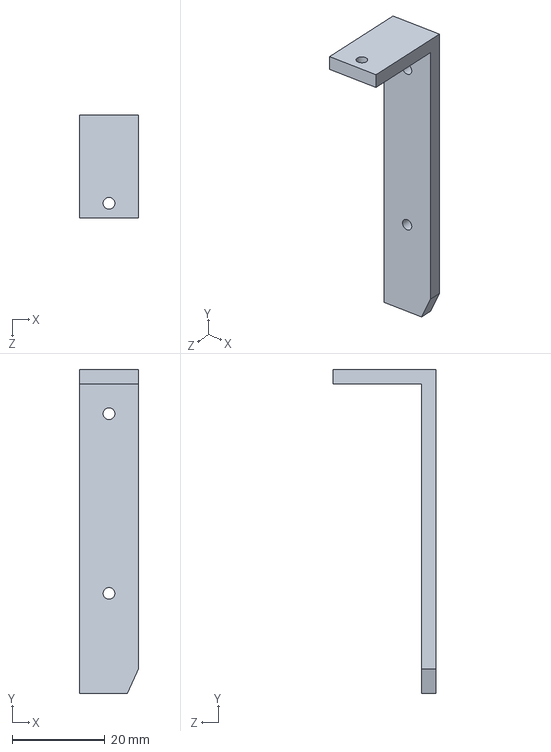
[picture p18: CAD file, 2023-10-02]
CAD/files/Parachute Mechanism/Spring Trigger Prototype/Trigger Lever.SLDPRT
12.7 x 69.8 x 22.2 mm
