esech19/tvc-and-test-rig/CAD/files/Parachute Mechanism/Concept 1 - Spring Trigger/Push Stick.SLDPRT

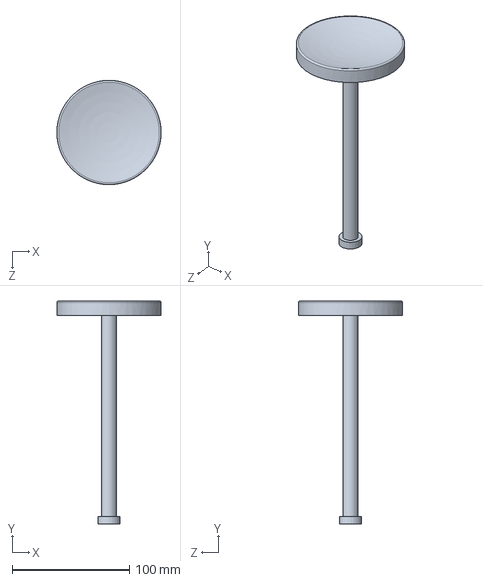
[picture p19: CAD file, 2023-10-02]
CAD/files/Parachute Mechanism/Concept 1 - Spring Trigger/Push Stick.SLDPRT
88.9 x 190.1 x 88.9 mm
