esech19/tvc-and-test-rig/CAD/files/Parachute Mechanism/Spring Trigger Prototype/Pusher disc.SLDPRT

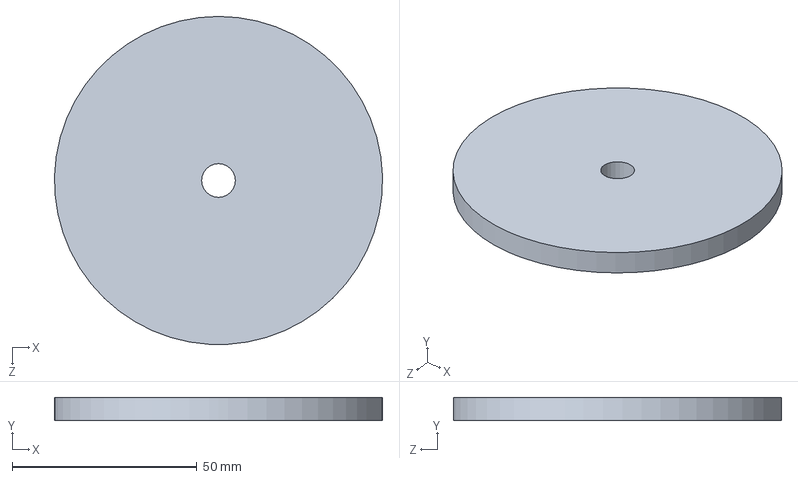
[picture p20: CAD file, 2023-10-02]
CAD/files/Parachute Mechanism/Spring Trigger Prototype/Pusher disc.SLDPRT
88.9 x 6.35 x 88.9 mm
