esech19/tvc-and-test-rig/CAD/files/Testing Rig/9-22-2022/Outer Gimbal Ring_9_22_2022.SLDPRT

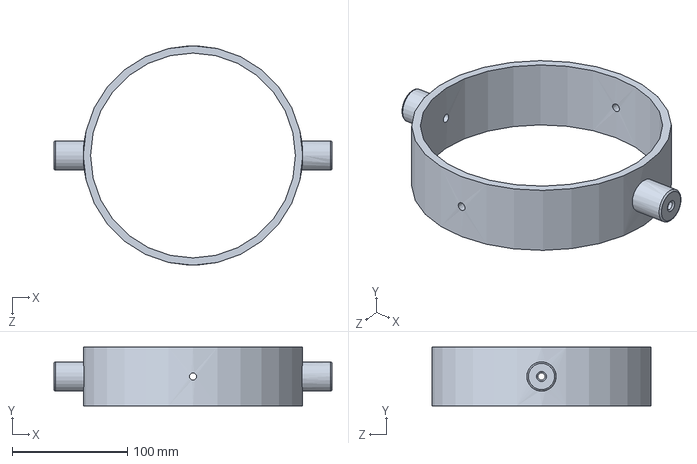
[picture p21: CAD file, 2023-10-02]
CAD/files/Testing Rig/9-22-2022/Outer Gimbal Ring_9_22_2022.SLDPRT
241.3 x 50.8 x 190.5 mm
