esech19/tvc-and-test-rig/CAD/files/Testing Rig/V3/Inner Gimbal Ring_otherpart.SLDPRT

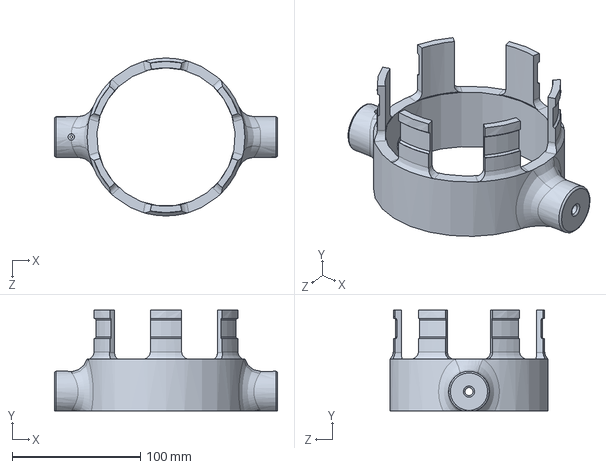
[picture p22: CAD file, 2023-10-02]
CAD/files/Testing Rig/V3/Inner Gimbal Ring_otherpart.SLDPRT
174.0 x 78.5 x 123.2 mm
