esech19/tvc-and-test-rig/CAD/files/Parachute Mechanism/Concept 1 - Spring Trigger/Tower-Pro-MG90S.SLDPRT

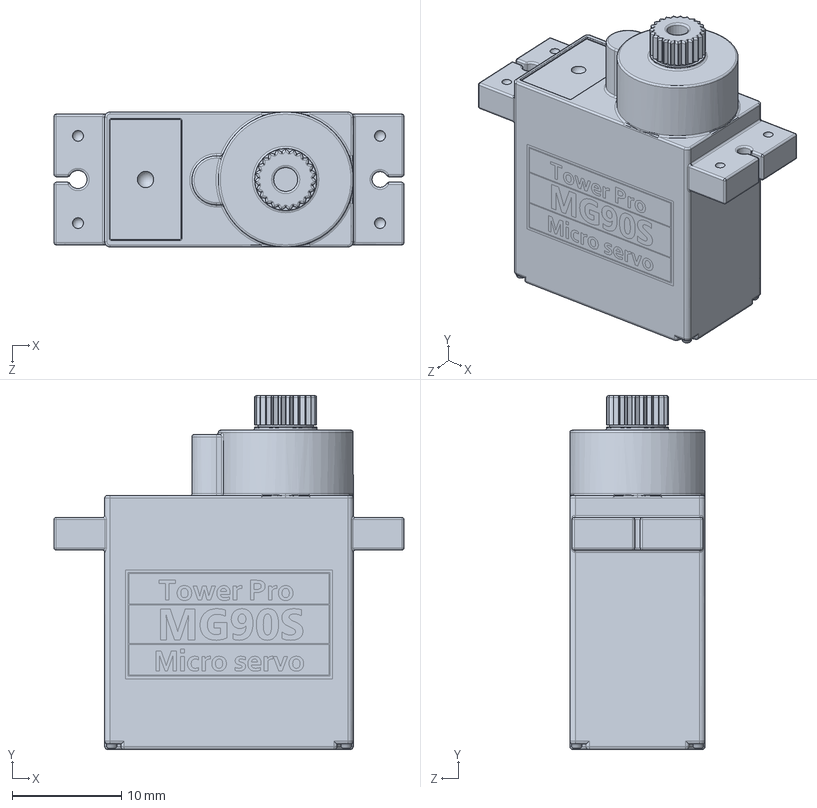
[picture p23: CAD file, 2023-10-02]
CAD/files/Parachute Mechanism/Concept 1 - Spring Trigger/Tower-Pro-MG90S.SLDPRT
32.1 x 32.5 x 12.4 mm
