esech19/tvc-and-test-rig/CAD/files/Parachute Mechanism/Spring Trigger Prototype/Spring Attachment Lever.SLDPRT

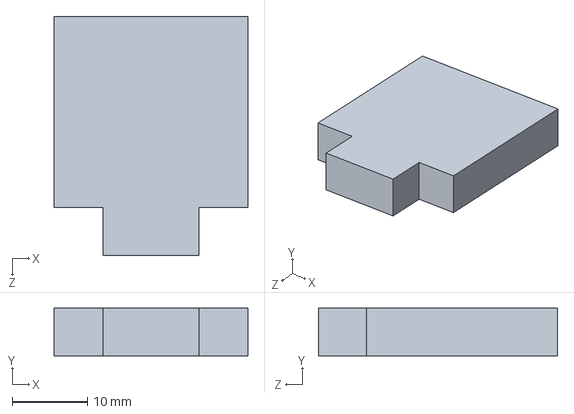
[picture p24: CAD file, 2023-10-02]
CAD/files/Parachute Mechanism/Spring Trigger Prototype/Spring Attachment Lever.SLDPRT
25.7 x 6.35 x 31.8 mm
