esech19/tvc-and-test-rig/CAD/files/Testing Rig/V3/Outer Gimbal Ring.SLDPRT

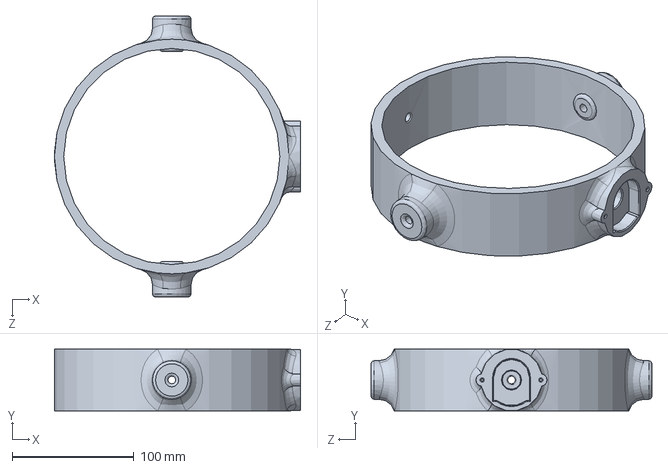
[picture p25: CAD file, 2023-10-02]
CAD/files/Testing Rig/V3/Outer Gimbal Ring.SLDPRT
202.4 x 50.8 x 231.1 mm
