esech19/tvc-and-test-rig/CAD/files/Testing Rig/10-3-22/2x4.SLDPRT

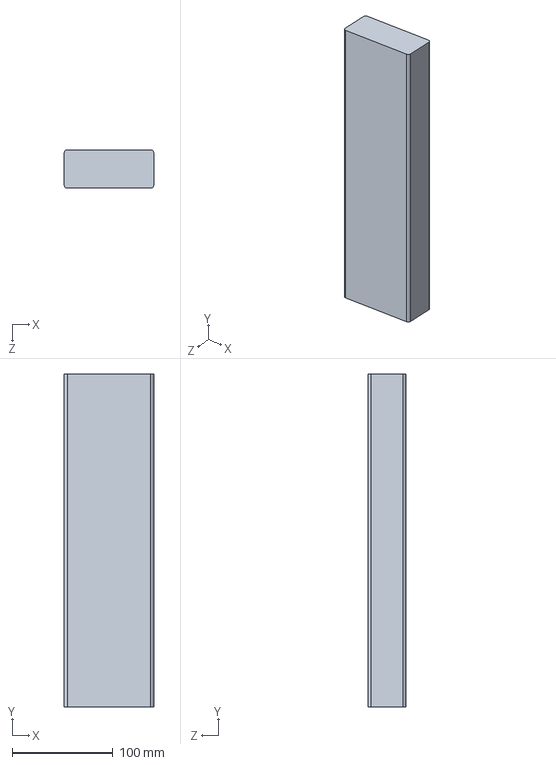
[picture p26: CAD file, 2023-10-02]
CAD/files/Testing Rig/10-3-22/2x4.SLDPRT
88.9 x 330.2 x 38.1 mm
