esech19/tvc-and-test-rig/CAD/files/Testing Rig/9-22-2022/S Tyep Load Cell TAS501_9_22_2022.SLDPRT

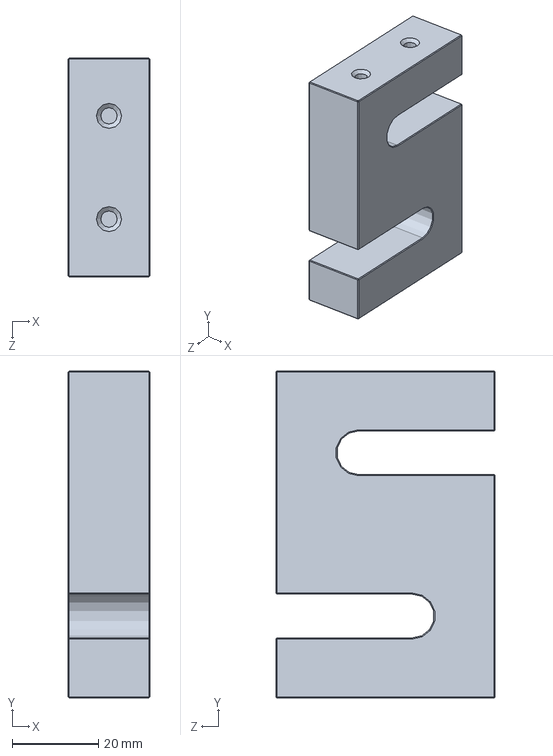
[picture p27: CAD file, 2023-10-02]
CAD/files/Testing Rig/9-22-2022/S Tyep Load Cell TAS501_9_22_2022.SLDPRT
19.0 x 76.0 x 51.0 mm
