esech19/tvc-and-test-rig/CAD/files/Parachute Mechanism/Concept 1 - Spring Trigger/Microservo horn.SLDPRT

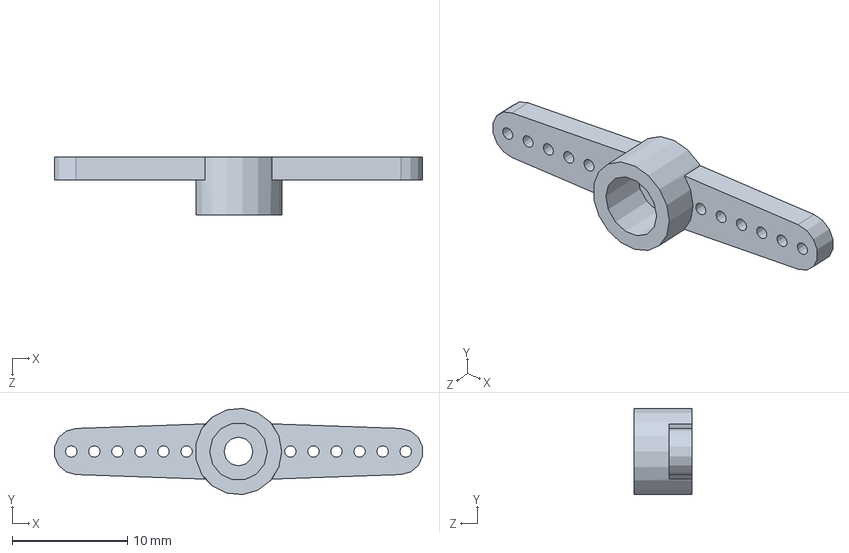
[picture p28: CAD file, 2023-10-02]
CAD/files/Parachute Mechanism/Concept 1 - Spring Trigger/Microservo horn.SLDPRT
31.9 x 7.47 x 5.00 mm
