esech19/tvc-and-test-rig/CAD/files/Parachute Mechanism/Spring Trigger Prototype/Outer rod cap.SLDPRT

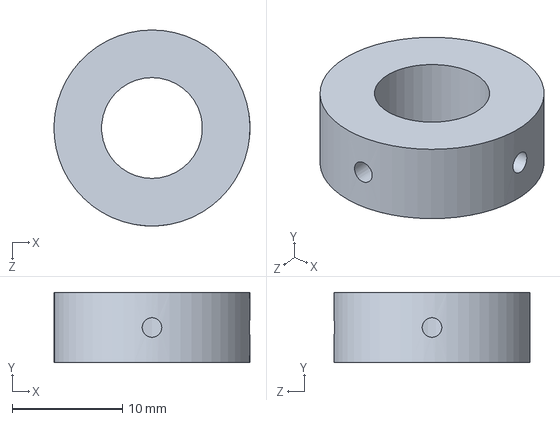
[picture p29: CAD file, 2023-10-02]
CAD/files/Parachute Mechanism/Spring Trigger Prototype/Outer rod cap.SLDPRT
17.8 x 6.35 x 17.8 mm
