esech19/tvc-and-test-rig/CAD/files/Parachute Mechanism/Concept 1 - Spring Trigger/Electrontics Bay.SLDPRT

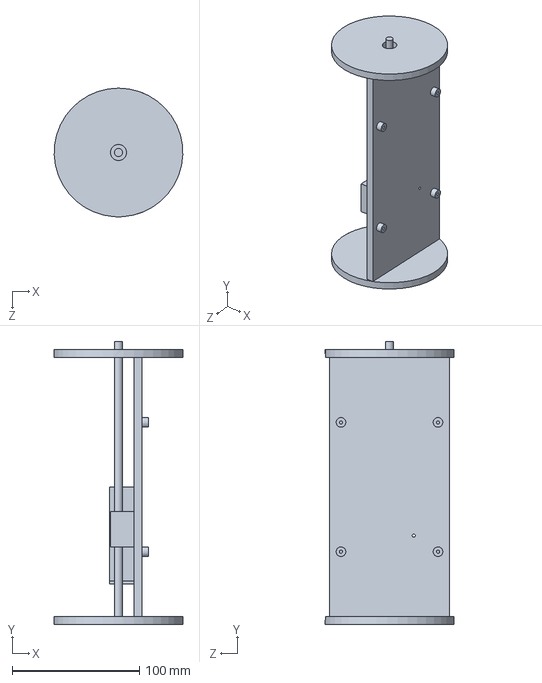
[picture p30: CAD file, 2023-10-02]
CAD/files/Parachute Mechanism/Concept 1 - Spring Trigger/Electrontics Bay.SLDPRT
101.0 x 222.2 x 101.1 mm
