esech19/tvc-and-test-rig/CAD/files/Testing Rig/9-22-2022/Inner Gimbal Ring_9_22_2022.SLDPRT

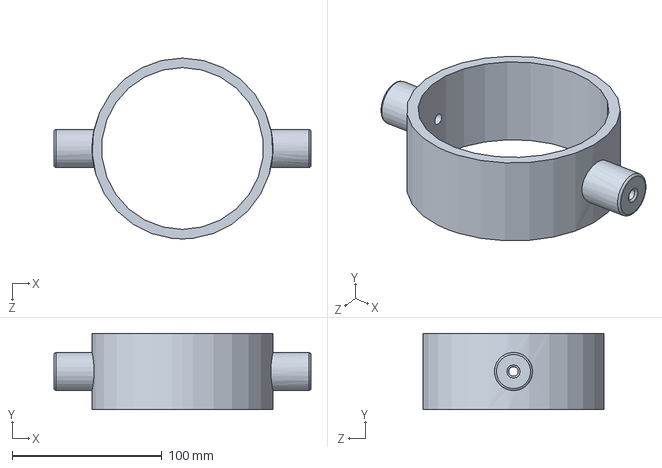
[picture p31: CAD file, 2023-10-02]
CAD/files/Testing Rig/9-22-2022/Inner Gimbal Ring_9_22_2022.SLDPRT
171.4 x 50.8 x 120.7 mm
