esech19/tvc-and-test-rig/CAD/files/Parachute Mechanism/Concept 1 - Spring Trigger/Servo plate.SLDPRT

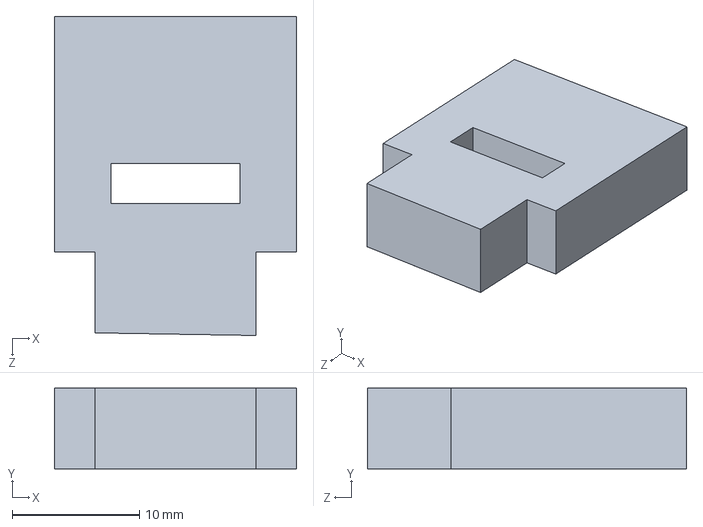
[picture p32: CAD file, 2023-10-02]
CAD/files/Parachute Mechanism/Concept 1 - Spring Trigger/Servo plate.SLDPRT
19.1 x 6.35 x 25.1 mm
