esech19/tvc-and-test-rig/CAD/files/Testing Rig/V3/Inner Gimbal Ring.SLDPRT

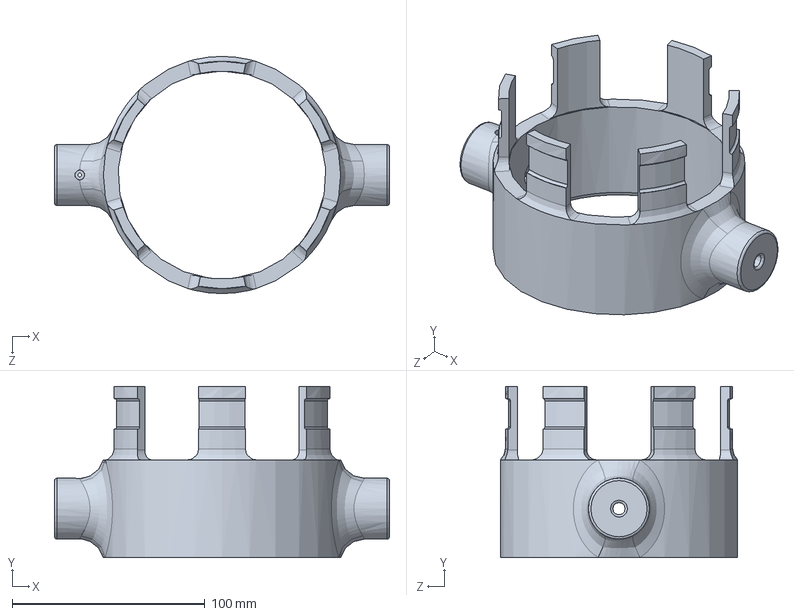
[picture p33: CAD file, 2023-10-02]
CAD/files/Testing Rig/V3/Inner Gimbal Ring.SLDPRT
174.0 x 88.9 x 123.2 mm
