esech19/tvc-and-test-rig/CAD/files/Parachute Mechanism/Spring Trigger Prototype/6516K6_Connecting Rod.SLDPRT

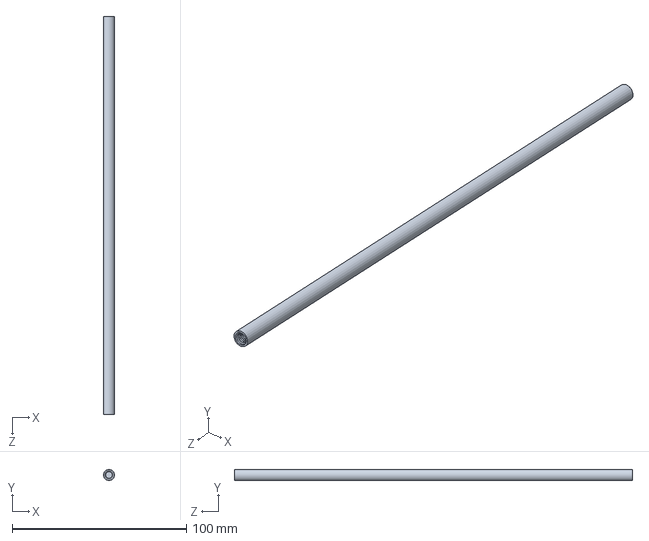
[picture p34: CAD file, 2023-10-02]
CAD/files/Parachute Mechanism/Spring Trigger Prototype/6516K6_Connecting Rod.SLDPRT
6.35 x 6.35 x 228.6 mm
