esech19/tvc-and-test-rig/CAD/files/Parachute Mechanism/Spring Trigger Prototype/Center piece.SLDPRT

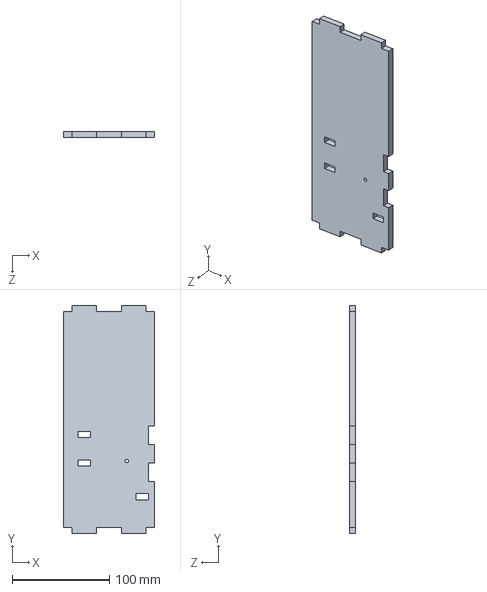
[picture p35: CAD file, 2023-10-02]
CAD/files/Parachute Mechanism/Spring Trigger Prototype/Center piece.SLDPRT
94.0 x 235.0 x 6.35 mm
