esech19/tvc-and-test-rig/CAD/files/Parachute Mechanism/Spring Trigger Prototype/Lever2.SLDPRT

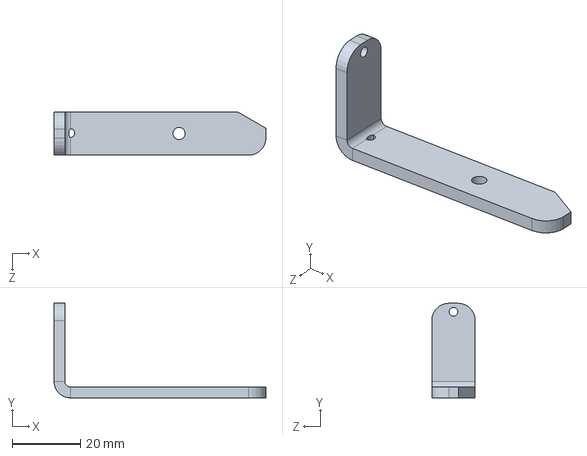
[picture p36: CAD file, 2023-10-02]
CAD/files/Parachute Mechanism/Spring Trigger Prototype/Lever2.SLDPRT
62.0 x 27.7 x 12.7 mm
