esech19/tvc-and-test-rig/CAD/files/Testing Rig/10-3-22/Inner Gimbal Ring.SLDPRT

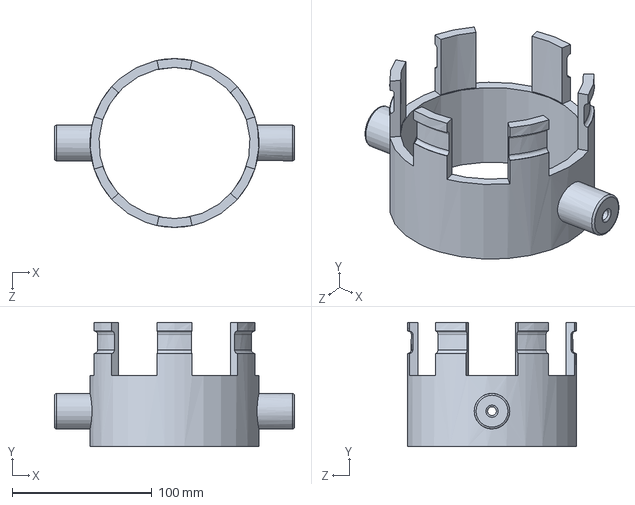
[picture p37: CAD file, 2023-10-02]
CAD/files/Testing Rig/10-3-22/Inner Gimbal Ring.SLDPRT
171.4 x 88.9 x 120.7 mm
