esech19/tvc-and-test-rig/CAD/files/Testing Rig/10-5-2022/CAD/Outer Gimbal Ring.SLDPRT

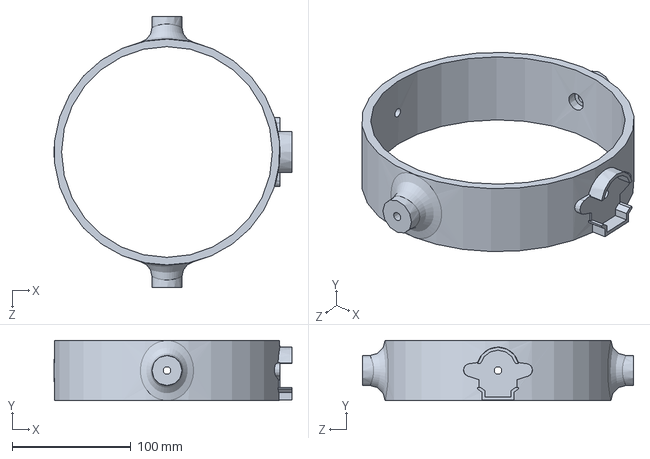
[picture p38: CAD file, 2023-10-02]
CAD/files/Testing Rig/10-5-2022/CAD/Outer Gimbal Ring.SLDPRT
200.7 x 50.8 x 228.6 mm
