esech19/tvc-and-test-rig/CAD/files/Parachute Mechanism/Spring Trigger Prototype/Lever hard stop.SLDPRT

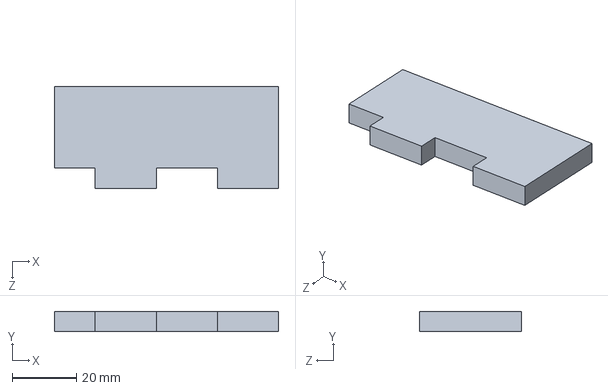
[picture p39: CAD file, 2023-10-02]
CAD/files/Parachute Mechanism/Spring Trigger Prototype/Lever hard stop.SLDPRT
69.8 x 6.35 x 31.8 mm
