esech19/tvc-and-test-rig/CAD/files/Testing Rig/10-5-2022/CAD/acrylicguard.SLDPRT

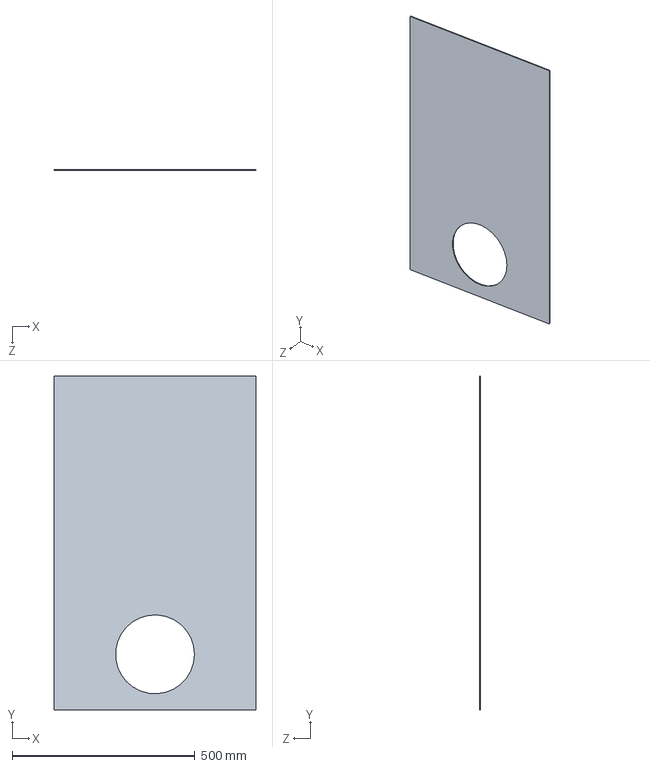
[picture p40: CAD file, 2023-10-02]
CAD/files/Testing Rig/10-5-2022/CAD/acrylicguard.SLDPRT
552.5 x 914.4 x 3.17 mm
