esech19/tvc-and-test-rig/CAD/files/Testing Rig/V3/4x4.SLDPRT

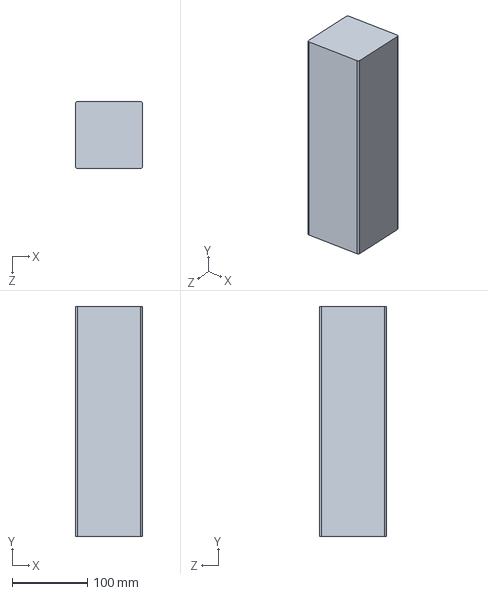
[picture p41: CAD file, 2023-10-02]
CAD/files/Testing Rig/V3/4x4.SLDPRT
88.9 x 304.8 x 88.9 mm
