esech19/tvc-and-test-rig/CAD/files/Testing Rig/V3/encoder cover.SLDPRT

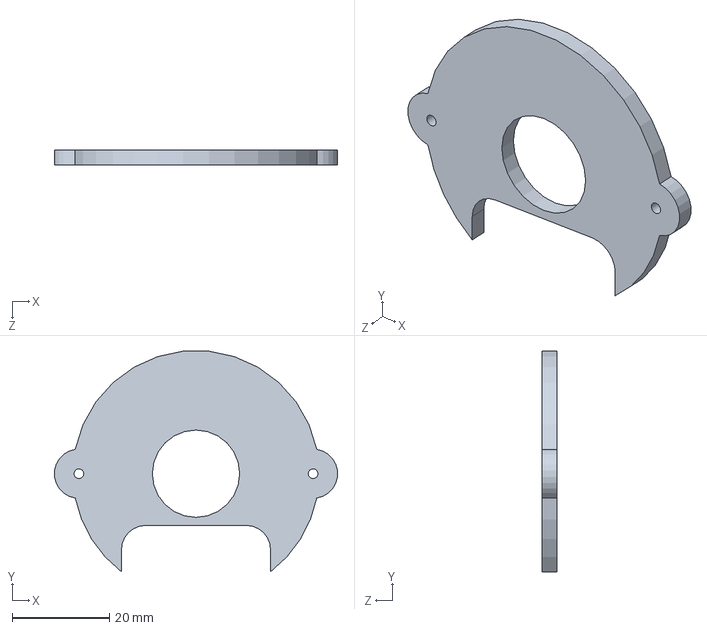
[picture p42: CAD file, 2023-10-02]
CAD/files/Testing Rig/V3/encoder cover.SLDPRT
58.3 x 45.5 x 3.17 mm
