esech19/tvc-and-test-rig/CAD/files/Testing Rig/V3/CUI_DEVICES_cui_devices_amt103-2048-n4000-s.sldasm

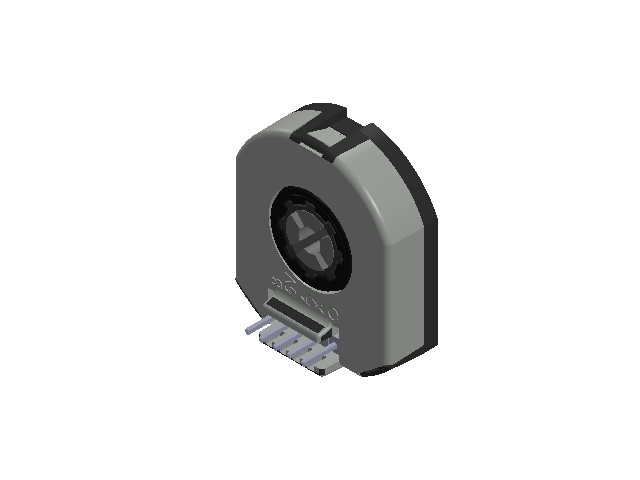
[picture p43: CAD file, 2023-10-02]
CAD/files/Testing Rig/V3/CUI_DEVICES_cui_devices_amt103-2048-n4000-s.sldasm
CUI_DEVICES_amt-sleeve-rev-d(4mm)
CUI_DEVICES_amt-hub-top-rev-d1
CUI_DEVICES_amt-hub-bottom-rev-b
CUI_DEVICES_amt10x-shaft-adaptor-rev-e
CUI_DEVICES_receiver-board
CUI_DEVICES_rotor-board-rev f
CUI_DEVICES_transmitter-board amt10(amt-103)
CUI_DEVICES_amt-103-base-rev-k(default)
CUI_DEVICES_amt-103-top-cover-rev-i
