esech19/tvc-and-test-rig/(list of files, cad)

Other CAD files:
CAD/files/Testing Rig/10-5-2022/CAD/CUI_DEVICES_Overmold_Rev_A.SLDASM
CAD/files/Testing Rig/V3/Gimbal Attachment Frame.SLDASM
CAD/files/Testing Rig/10-3-22/CUI_DEVICES_Transmitter-board with connector(locking connector).SLDASM
CAD/files/Testing Rig/10-3-22/Test Rig Gimbal.SLDASM
CAD/files/Testing Rig/10-5-2022/CAD/CUI_DEVICES_Transmitter-board with connector(locking connector).SLDASM
CAD/files/Testing Rig/10-3-22/CUI_DEVICES_Overmold_Rev_A.SLDASM
CAD/files/Testing Rig/10-5-2022/CAD/Wooden Structure.SLDASM
CAD/files/Testing Rig/V3/Wooden Structure.SLDASM
CAD/files/Testing Rig/10-3-22/CUI_DEVICES_TFML-107-01-X-D-BASIC.SLDPRT
CAD/files/Testing Rig/10-3-22/CUI_DEVICES_AMT-Overmold_Hub-REV_A.SLDPRT
CAD/files/Testing Rig/V3/CUI_DEVICES_amt10x-shaft-adaptor-rev-e.sldprt
CAD/files/Testing Rig/10-3-22/CUI_DEVICES_Receiver-board.SLDPRT
CAD/files/Testing Rig/10-3-22/CUI_DEVICES_AMT-Shaft-Adaptor-REVD_Fixed.SLDPRT
CAD/files/Testing Rig/9-22-2022/2x4_9_22_2022.SLDPRT
CAD/files/Testing Rig/10-3-22/S Tyep Load Cell TAS501.SLDPRT
CAD/files/Testing Rig/10-5-2022/CAD/CUI_DEVICES_amt-x03-wide-base rev b(default).SLDPRT
CAD/files/Testing Rig/V3/CUI_DEVICES_amt-103-base-rev-k(default).sldprt
CAD/files/Parachute Mechanism/Spring Trigger Prototype/Top Disc.SLDPRT
CAD/files/Testing Rig/10-3-22/CUI_DEVICES_AMT-103-Base-REV-K(Default).sldprt
CAD/files/Testing Rig/10-5-2022/CAD/CUI_DEVICES_Receiver-board.SLDPRT
CAD/files/Testing Rig/10-3-22/CUI_DEVICES_Rotor_16f_5c_Rev_D.SLDPRT
CAD/files/Testing Rig/10-3-22/CUI_DEVICES_Transmitter-board(AMT203-303).SLDPRT
CAD/files/Testing Rig/10-5-2022/CAD/CUI_DEVICES_AMT-203_303-Top-Cover_Rev_H.SLDPRT
CAD/files/Testing Rig/V3/CUI_DEVICES_receiver-board.sldprt
CAD/files/Testing Rig/10-5-2022/CAD/S Tyep Load Cell TAS501.SLDPRT
CAD/files/Testing Rig/V3/CUI_DEVICES_amt-hub-top-rev-d1.sldprt
CAD/files/Testing Rig/10-5-2022/CAD/CUI_DEVICES_Transmitter-board(AMT203-303).SLDPRT
CAD/files/Testing Rig/V3/CUI_DEVICES_amt-sleeve-rev-d(4mm).sldprt
CAD/files/Testing Rig/10-3-22/CUI_DEVICES_amt-x03-wide-base rev b(default).SLDPRT
CAD/files/Testing Rig/10-5-2022/CAD/CUI_DEVICES_AMT-Overmold_Hub-REV_A.SLDPRT
CAD/files/Testing Rig/10-5-2022/CAD/CUI_DEVICES_AMT-Sleeve-REV-D( 2 mm).SLDPRT
CAD/files/Testing Rig/V3/CUI_DEVICES_rotor-board-rev f.sldprt
CAD/files/Testing Rig/10-3-22/CUI_DEVICES_AMT-203_303-Top-Cover_Rev_H.SLDPRT
CAD/files/Testing Rig/10-5-2022/CAD/CUI_DEVICES_AMT-Shaft-Adaptor-REVD_Fixed.SLDPRT
CAD/files/Testing Rig/10-3-22/CUI_DEVICES_AMT-Sleeve-REV-D( 2 mm).SLDPRT
CAD/files/Testing Rig/10-5-2022/CAD/CUI_DEVICES_TFML-107-01-X-D-BASIC.SLDPRT
CAD/files/Testing Rig/V3/CUI_DEVICES_amt-103-top-cover-rev-i.sldprt
CAD/files/Testing Rig/10-3-22/Outer Gimbal Ring.SLDPRT
CAD/files/Testing Rig/10-5-2022/CAD/CUI_DEVICES_AMT-103-Base-REV-K(Default).sldprt
CAD/files/Testing Rig/10-5-2022/CAD/Inner Gimbal Ring.SLDPRT
CAD/files/Testing Rig/V3/CUI_DEVICES_amt-hub-bottom-rev-b.sldprt
CAD/files/Testing Rig/V3/S Tyep Load Cell TAS501.SLDPRT
CAD/files/Testing Rig/V3/CUI_DEVICES_transmitter-board amt10(amt-103).sldprt
CAD/files/Testing Rig/V3/TAZ5SE05MM_Inner Gimbal Ring.3mf
CAD/files/Parachute Mechanism/Concept 1 - Spring Trigger/9044K19_Music-Wire Steel Extension Spring.SLDPRT
CAD/files/Parachute Mechanism/Concept 1 - Spring Trigger/9657K449_Compression Spring.SLDPRT
CAD/files/Parachute Mechanism/Spring Trigger Prototype/5287T611_Ultra-Strength Lightweight Carbon Fiber Tube.SLDPRT
CAD/files/Parachute Mechanism/Spring Trigger Prototype/90631A007_Low-Strength Steel Nylon-Insert Locknut.SLDPRT
CAD/files/Parachute Mechanism/Spring Trigger Prototype/91251A152_Black-Oxide Alloy Steel Socket Head Screw.SLDPRT
CAD/files/Parachute Mechanism/Spring Trigger Prototype/91251A345_Black-Oxide Alloy Steel Socket Head Screw.SLDPRT
CAD/files/Parachute Mechanism/Spring Trigger Prototype/91253A008_Black-Oxide Alloy Steel Hex Drive Flat Head Screw.SLDPRT
CAD/files/Parachute Mechanism/Spring Trigger Prototype/92141A011_18-8 Stainless Steel Washer.SLDPRT
CAD/files/Parachute Mechanism/Spring Trigger Prototype/92510A443_Aluminum Unthreaded Spacer.SLDPRT
CAD/files/Parachute Mechanism/Spring Trigger Prototype/9657K301_Compression Spring.SLDPRT
CAD/files/Testing Rig/10-3-22/5415K87_Worm-Drive Clamps for Firm Hose and Tube.SLDPRT
CAD/files/Testing Rig/10-3-22/91259A103_Alloy Steel Shoulder Screw.SLDPRT
CAD/files/Testing Rig/10-5-2022/CAD/1556A36_Zinc-Plated Steel Corner Bracket.SLDPRT
CAD/files/Testing Rig/10-5-2022/CAD/91259A103_Alloy Steel Shoulder Screw.SLDPRT
CAD/files/Testing Rig/10-5-2022/CAD/91259A104_Alloy Steel Shoulder Screw.SLDPRT
CAD/files/Testing Rig/10-5-2022/CAD/92105A006_Zinc Alloy Tapping Inserts for Softwood.SLDPRT
CAD/files/Testing Rig/V3/1556A36_Zinc-Plated Steel Corner Bracket.SLDPRT
CAD/files/Testing Rig/V3/5415K87_Worm-Drive Clamps for Firm Hose and Tube.SLDPRT
CAD/files/Testing Rig/V3/91259A103_Alloy Steel Shoulder Screw.SLDPRT
CAD/files/Testing Rig/V3/91259A104_Alloy Steel Shoulder Screw.SLDPRT
CAD/files/Testing Rig/V3/91259A471_Alloy Steel Shoulder Screw.SLDPRT
CAD/files/Testing Rig/V3/91545A330_Lubricant-Filled Nylon Plastic Washer.SLDPRT
CAD/files/Testing Rig/V3/92105A006_Zinc Alloy Tapping Inserts for Softwood.SLDPRT
CAD/files/Testing Rig/V3/93729A108_Aluminum Unthreaded Inserts for Plastic.SLDPRT
CAD/files/Testing Rig/V3/Inner Gimbal Ring.STL
CAD/files/Testing Rig/V3/Inner Gimbal Ring_otherpart.STL
CAD/files/Testing Rig/V3/Outer Gimbal Ring.STL
