esech19/tvc-and-test-rig/Testing/Sweep Tests in Rig/3-30-2023/Copy of test1data.txt

137.60,-0.25,1.05,-5.63
137.62,-0.27,1.05,-5.63
137.65,-0.25,1.05,-5.63
137.67,-0.28,1.05,-5.63
137.70,-0.26,1.05,-5.63
137.73,-0.26,1.05,-5.63
137.75,-0.26,1.05,-5.63
137.78,-0.35,1.05,-5.45
137.80,-0.40,0.88,-5.10
137.83,-0.44,0.70,-4.92
137.86,-0.45,0.70,-4.92
137.88,-0.47,0.00,-4.92
137.91,-0.48,-2.11,-4.75
137.94,-0.49,-4.57,-4.57
137.96,-0.52,-7.21,-4.39
137.99,-0.53,-9.84,-4.22
138.02,-0.51,-12.48,-4.04
138.05,-0.43,-14.94,-3.87
138.07,-0.45,-16.70,-3.87
138.10,-0.50,-17.93,-3.69
138.13,-0.48,-18.63,-3.52
138.16,-0.43,-18.46,-3.52
138.19,-0.47,-18.46,-3.52
138.21,-0.44,-18.46,-3.52
138.24,-0.45,-16.35,-3.52
138.27,-0.47,-13.36,-3.69
138.30,-0.51,-9.67,-4.04
138.32,-0.51,-6.33,-4.22
138.35,-0.50,-2.99,-4.22
138.38,-0.52,-0.18,-4.22
138.41,-0.59,1.93,-4.22
138.43,-0.38,2.46,-4.22
138.46,-0.41,2.11,-4.22
138.48,-0.51,1.93,-4.22
138.51,-0.57,0.70,-4.22
138.54,-0.67,-2.11,-4.22
138.56,-0.65,-5.98,-4.22
138.59,-0.56,-9.67,-4.22
138.62,-0.62,-13.36,-4.22
138.65,-0.60,-16.87,-4.22
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
