esech19/tvc-and-test-rig/Testing/Sweep Tests in Rig/3-30-2023/TEST_0 - 3_30_23.TXT

Servo X (#1) Test):
0,143
10,73
20,143
30,144
40,145
50,146
60,147
70,148
80,149
90,150
100,151
110,152
120,153
130,154
140,155
150,156
160,157
170,158
180,159
190,160
200,161
210,162
220,163
230,163
240,162
250,161
260,160
270,159
280,158
290,157
300,156
310,155
320,154
330,153
340,152
350,151
360,150
370,149
380,148
390,147
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
Servo X (#1) Test):
840,143
10,73
20,143
30,144
40,145
50,146
60,147
70,148
80,149
90,150
100,151
110,152
120,153
130,154
140,155
150,156
160,157
170,158
180,159
190,160
200,161
210,162
220,163
230,163
240,162
250,161
260,160
270,159
280,158
290,157
300,156
310,155
320,154
330,153
340,152
350,151
360,150
370,149
380,148
390,147
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
Servo X (#1) Test):
840,143
10,73
20,143
30,144
40,145
50,146
60,147
70,148
80,149
90,150
100,151
110,152
120,153
130,154
140,155
150,156
160,157
170,158
180,159
190,160
200,161
210,162
220,163
230,163
240,162
250,161
260,160
270,159
280,158
290,157
300,156
310,155
320,154
330,153
340,152
350,151
360,150
370,149
380,148
390,147
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
Servo X (#1) Test):
840,143
10,73
20,143
30,144
40,145
50,146
60,147
70,148
80,149
90,150
100,151
110,152
120,153
130,154
140,155
150,156
160,157
170,158
180,159
190,160
200,161
210,162
220,163
230,163
240,162
250,161
260,160
270,159
280,158
290,157
300,156
310,155
320,154
330,153
340,152
350,151
360,150
370,149
380,148
390,147
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
Servo X (#1) Test):
840,143
10,73
20,143
30,144
40,145
50,146
60,147
70,148
80,149
90,150
100,151
110,152
120,153
130,154
140,155
150,156
160,157
170,158
180,159
190,160
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
20,143
30,144
40,145
50,146
60,147
70,148
80,149
90,150
100,151
110,152
120,153
130,154
140,155
150,156
160,157
170,158
180,159
190,160
200,161
210,162
220,163
230,163
240,162
250,161
260,160
270,159
280,158
290,157
300,156
310,155
320,154
330,153
340,152
350,151
360,150
370,149
380,148
390,147
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
Servo X (#1) Test):
840,143
10,73
20,143
30,144
40,145
50,146
60,147
70,148
80,149
90,150
100,151
110,152
120,153
130,154
140,155
150,156
160,157
170,158
180,159
190,160
200,161
210,162
220,163
230,163
240,162
250,161
260,160
270,159
280,158
290,157
300,156
310,155
320,154
330,153
340,152
350,151
360,150
370,149
380,148
390,147
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
