esech19/tvc-and-test-rig/Testing/Sweep Tests in Rig/4-9_11-23 (no launch)/TEST_7 - 4_9_23.TXT

Servo X Run: 0
0.83,143
0.84,143
0.85,144
0.86,145
0.87,146
0.88,147
0.89,148
0.90,149
0.91,150
0.92,151
0.93,152
0.94,153
0.96,154
0.97,155
0.98,156
0.99,157
1.00,158
1.01,159
1.02,160
1.03,161
1.04,162
1.05,163
1.06,163
1.07,162
1.08,161
1.09,160
1.10,159
1.11,158
1.12,157
1.13,156
1.14,155
1.15,154
1.16,153
1.17,152
1.18,151
1.19,150
1.20,149
1.21,148
1.22,147
1.23,146
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
Servo X Run: 1
1.91,143
1.92,143
1.93,144
1.94,145
1.95,146
1.96,147
1.97,148
1.98,149
1.99,150
2.00,151
2.01,152
2.02,153
2.03,154
2.04,155
2.05,156
2.06,157
2.09,158
2.10,159
2.11,160
2.12,161
2.13,162
2.14,163
2.15,163
2.16,162
2.17,161
2.18,160
2.19,159
2.20,158
2.21,157
2.22,156
2.23,155
2.24,154
2.25,153
2.26,152
2.27,151
2.28,150
2.29,149
2.30,148
2.31,147
2.32,146
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
Servo X Run: 2
2.87,143
2.88,143
2.89,144
2.90,145
2.91,146
2.92,147
2.93,148
2.94,149
2.95,150
2.96,151
2.97,152
2.98,153
2.99,154
3.00,155
3.01,156
3.02,157
3.03,158
3.04,159
3.05,160
3.06,161
3.07,162
3.08,163
3.09,163
3.10,162
3.11,161
3.12,160
3.13,159
3.14,158
3.15,157
3.16,156
3.17,155
3.18,154
3.19,153
3.22,152
3.23,151
3.24,150
3.25,149
3.26,148
3.27,147
3.28,146
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
Servo X Run: 3
3.83,143
3.84,143
3.85,144
3.86,145
3.87,146
3.88,147
3.89,148
3.90,149
3.91,150
3.92,151
3.93,152
3.94,153
3.95,154
3.96,155
3.97,156
3.98,157
3.99,158
4.00,159
4.01,160
4.02,161
4.03,162
4.04,163
4.05,163
4.06,162
4.07,161
4.08,160
4.09,159
4.10,158
4.11,157
4.12,156
4.13,155
4.14,154
4.15,153
4.16,152
4.17,151
4.18,150
4.19,149
4.20,148
4.21,147
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
158.75,155
158.76,156
158.77,157
158.78,158
158.79,159
158.80,160
158.81,161
158.82,162
158.83,163
158.84,163
158.85,162
158.86,161
158.87,160
158.89,159
158.90,158
158.91,157
158.92,156
158.93,155
158.94,154
158.95,153
158.96,152
158.97,151
158.98,150
158.99,149
159.00,148
159.01,147
159.02,146
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
Servo X Run: 160
159.58,143
159.59,143
159.60,144
159.61,145
159.62,146
159.63,147
159.65,148
159.66,149
159.67,150
159.68,151
159.69,152
159.70,153
159.71,154
159.72,155
159.73,156
159.74,157
159.75,158
159.76,159
159.77,160
159.78,161
159.79,162
159.80,163
159.81,163
159.82,162
159.83,161
159.84,160
159.86,159
159.87,158
159.88,157
159.89,156
159.90,155
159.91,154
159.92,153
159.93,152
159.94,151
159.95,150
159.96,149
159.97,148
159.98,147
159.99,146
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
Servo X Run: 161
160.55,143
160.56,143
160.57,144
160.58,145
160.59,146
160.61,147
160.62,148
160.63,149
160.64,150
160.65,151
160.66,152
160.67,153
160.68,154
160.69,155
160.70,156
160.71,157
160.72,158
160.73,159
160.74,160
160.75,161
160.76,162
160.77,163
160.78,163
160.79,162
160.80,161
160.81,160
160.83,159
160.84,158
160.85,157
160.86,156
160.87,155
160.88,154
160.89,153
160.90,152
160.91,151
160.92,150
160.93,149
160.94,148
160.95,147
160.96,146
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
