esech19/tvc-and-test-rig/Testing/Sweep Tests in Rig/4-12-23/Rocket Data/TEST_0.TXT

Start Time: 133.00
132.00,143.00
131.00,144.00
130.00,145.00
129.00,146.00
128.00,147.00
127.00,148.00
126.00,149.00
125.00,150.00
124.00,151.00
123.00,152.00
123.00,153.00
124.00,154.00
125.00,155.00
126.00,156.00
127.00,157.00
128.00,158.00
129.00,159.00
130.00,160.00
131.00,161.00
132.00,162.00
133.00,163.00
134.00,163.00
135.00,162.00
136.00,161.00
137.00,160.00
138.00,159.00
139.00,158.00
140.00,157.00
141.00,156.00
142.00,155.00
377.73,154.00
389.91,153.00
402.09,152.00
414.27,151.00
426.48,150.00
438.67,149.00
450.85,148.00
463.03,147.00
475.25,146.00
487.43,145.00
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
