esech19/tvc-and-test-rig/Testing/Test RIg/Test Rig Scripts, Files, and Data/Impulse_Data.csv

X | CH1 | Start | Increment
Sequence | Volt | -6.00E-03 | 1.00E-06
0 | -2.00E-02
1 | -2.00E-02
2 | -2.00E-02
3 | -2.00E-02
4 | -2.00E-02
5 | -2.00E-02
6 | -2.00E-02
7 | -2.00E-02
8 | -2.00E-02
9 | -2.00E-02
10 | -2.00E-02
11 | -2.00E-02
12 | -2.00E-02
13 | -2.00E-02
14 | -2.00E-02
15 | -2.00E-02
16 | -2.00E-02
17 | -2.00E-02
18 | -2.00E-02
19 | -2.00E-02
20 | -2.00E-02
21 | -2.00E-02
22 | -2.00E-02
23 | -2.00E-02
24 | -2.00E-02
25 | -2.00E-02
26 | -2.00E-02
27 | -2.00E-02
28 | -2.00E-02
29 | -2.00E-02
30 | -2.00E-02
31 | -2.00E-02
32 | -2.00E-02
33 | -2.00E-02
34 | -2.00E-02
35 | -2.00E-02
36 | -2.00E-02
37 | -2.00E-02
38 | -2.00E-02
39 | -2.00E-02
40 | -2.00E-02
41 | -2.00E-02
42 | -2.00E-02
43 | -2.00E-02
44 | -2.00E-02
45 | -2.00E-02
46 | -2.00E-02
47 | -2.00E-02
48 | -2.00E-02
49 | -2.00E-02
50 | -2.00E-02
51 | -2.00E-02
52 | -2.00E-02
53 | -2.00E-02
54 | -2.00E-02
55 | -2.00E-02
56 | -2.00E-02
57 | -2.00E-02
58 | -2.00E-02
59 | -2.00E-02
60 | -2.00E-02
61 | -2.00E-02
62 | -2.00E-02
63 | -2.00E-02
64 | -2.00E-02
65 | -2.00E-02
66 | -2.00E-02
67 | -2.00E-02
68 | -2.00E-02
69 | -2.00E-02
70 | -2.00E-02
71 | -2.00E-02
72 | -2.00E-02
73 | -2.00E-02
74 | -2.00E-02
75 | -2.00E-02
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
