esech19/tvc-and-test-rig/(commit log)

2023-10-02 first small file folders
    [Component Weights.xlsx, GANTT Chart TVC Rocket Honors Research.xlsx, Impulse_Data.csv, Impulse_Data_Original.csv, Parts List_.xlsx, SURG.xlsx, Servo Angles.xlsx]
2023-10-02 uploading cad files
    [1556A36_Zinc-Plated Steel Corner Bracket.SLDPRT, 2x4.SLDPRT, 2x4_9_22_2022.SLDPRT, 4x4.SLDPRT, 5287T611_Ultra-Strength Lightweight Carbon Fiber Tube.SLDPRT, 5415K87_Worm-Drive Clamps for Firm Hose and Tube.SLDPRT, 6516K6_Connecting Rod.SLDPRT, 9044K19_Music-Wire Steel Extension Spring.SLDPRT]
